eSpark-Consulting-Group/brad-fairman-led-project/Design-Files/Flex-Cable-LED Board_v2.0/Deliverables/Renderings/3D_Top_View.PNG

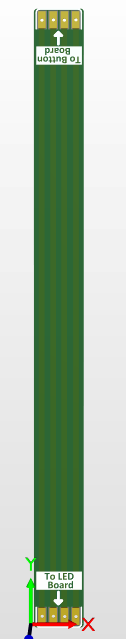
Design-Files/Flex-Cable-LED Board_v2.0/Deliverables/Renderings/3D_Top_View.PNG
