eSpark-Consulting-Group/brad-fairman-led-project/README.md

# Sekure Networks LED Project
#### Client Name: Brad Fairman
