eSpark-Consulting-Group/brad-fairman-led-project/Firmware/Arduino/LED-Project/README.md

# Sekure Networks LED Project
#### Client Name: Brad Fairman

<p>This arduino project requires MegaTINYcore Board Library to be installed first.</p>
<p>Press File>Preferences and add the following link into the "Additional Board Manager URL:" field.</p>
<p>http://drazzy.com/package_drazzy.com_index.json</p>

<p>Select ATtiny1616 as chip and 20MHz internal clock.</p>
