eSpark-Consulting-Group/brad-fairman-led-project/Design-Files/Button-Board_v2.0/Deliverables/Renderings/2D_Bottom_Layer.png

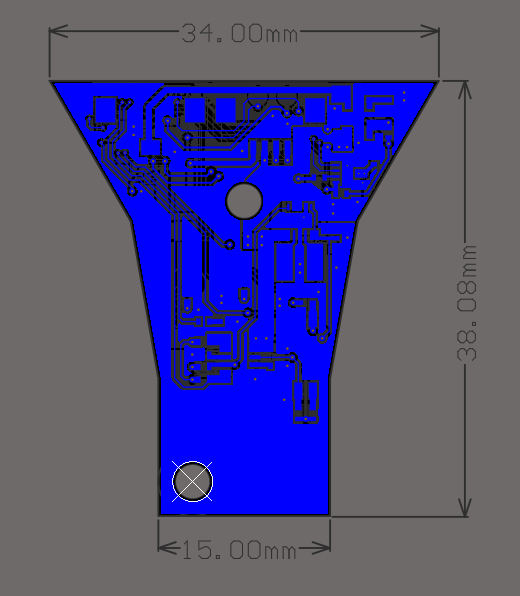
Design-Files/Button-Board_v2.0/Deliverables/Renderings/2D_Bottom_Layer.png
