eSpark-Consulting-Group/brad-fairman-led-project/Design-Files/Button-Board_v2.0/Deliverables/Renderings/3D_Isometric-View.png

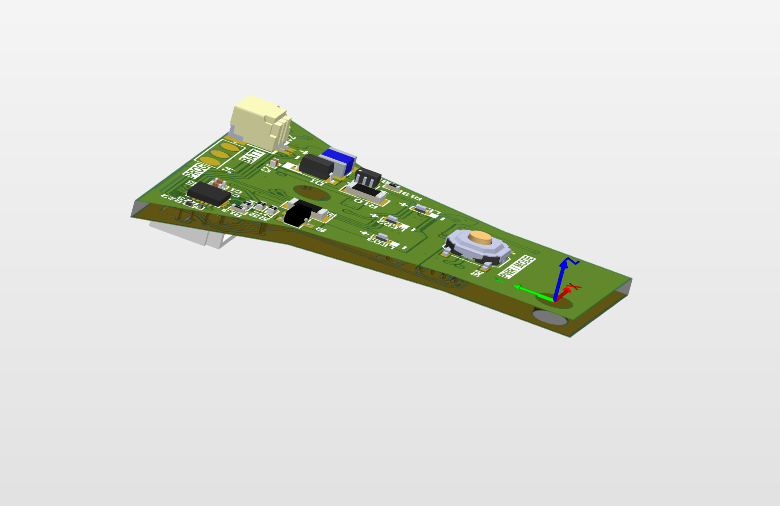
Design-Files/Button-Board_v2.0/Deliverables/Renderings/3D_Isometric-View.png
