eSpark-Consulting-Group/brad-fairman-led-project/Design-Files/Flex-Cable-LED Board_v2.0/Deliverables/Renderings/2D_C_View.PNG

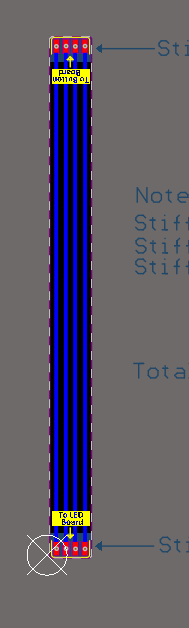
Design-Files/Flex-Cable-LED Board_v2.0/Deliverables/Renderings/2D_C_View.PNG
