eSpark-Consulting-Group/brad-fairman-led-project/Design-Files/Flex-Cable-USB_v2.0/Deliverables/Renderings/2D_Bottom_Layer.PNG

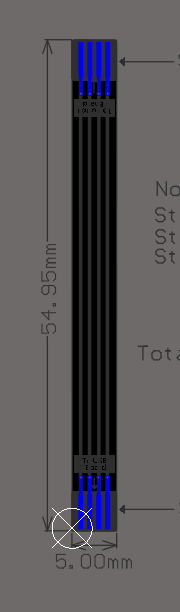
Design-Files/Flex-Cable-USB_v2.0/Deliverables/Renderings/2D_Bottom_Layer.PNG
