eSpark-Consulting-Group/brad-fairman-led-project/Design-Files/Flex-Cable-USB_v2.0/Deliverables/Renderings/2D_C_View.PNG

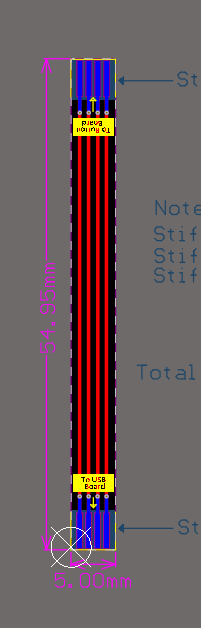
Design-Files/Flex-Cable-USB_v2.0/Deliverables/Renderings/2D_C_View.PNG
