eSpark-Consulting-Group/brad-fairman-led-project/Design-Files/Flex-Cable-USB_v2.0/Deliverables/Renderings/3D_Bottom_View.PNG

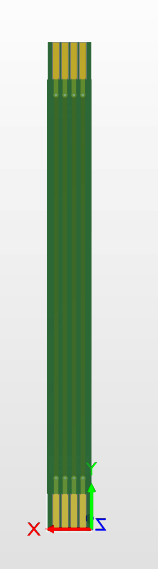
Design-Files/Flex-Cable-USB_v2.0/Deliverables/Renderings/3D_Bottom_View.PNG
