eSpark-Consulting-Group/brad-fairman-led-project/Design-Files/LED-Board_v2.0/Deliverables/Renderings/2D_Copper_Layer.png

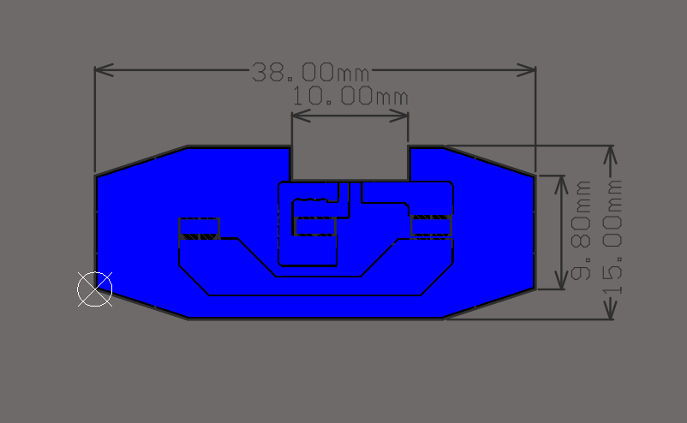
Design-Files/LED-Board_v2.0/Deliverables/Renderings/2D_Copper_Layer.png
