eSpark-Consulting-Group/brad-fairman-led-project/Design-Files/LED-Board_v2.0/Deliverables/Renderings/3D_Isometric_View.PNG

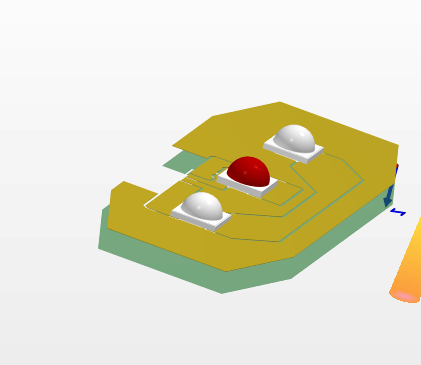
Design-Files/LED-Board_v2.0/Deliverables/Renderings/3D_Isometric_View.PNG
