eSpark-Consulting-Group/brad-fairman-led-project/Design-Files/LED-Board_v2.0/Deliverables/Renderings/3D_Top_View.PNG.png

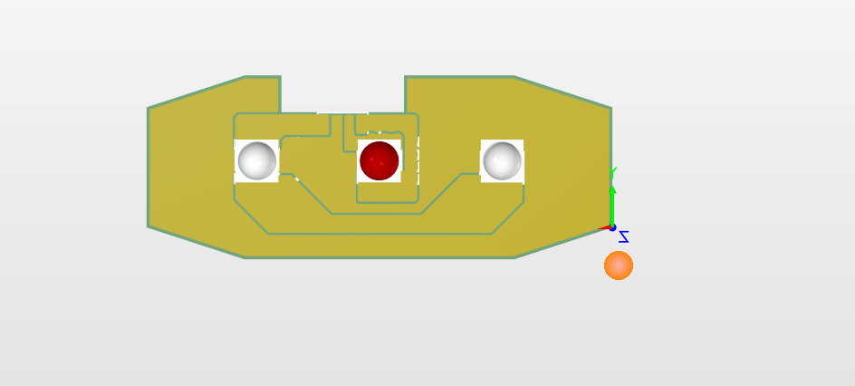
Design-Files/LED-Board_v2.0/Deliverables/Renderings/3D_Top_View.PNG.png
