eSpark-Consulting-Group/brad-fairman-led-project/Design-Files/USB-Board_v2.0/Deliverables/Renderings/2D_Top-Layer.png

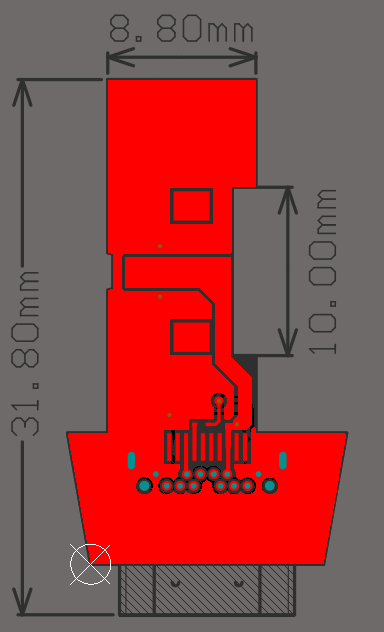
Design-Files/USB-Board_v2.0/Deliverables/Renderings/2D_Top-Layer.png
