eSpark-Consulting-Group/brad-fairman-led-project/Design-Files/Button-Board_v2.0/Deliverables/BOM/Button-Board_v2.0.xlsx

# | Item Type | Designator | Description | Footprint | Manufacturer Part Number | Manufacturer | Comment | Quantity | #Column Name Error:' Remarks
1 | Capacitor, [NoParam] | C1, C10, C12 | 1 µF ±20% 6.3V Ceramic Capacitor X5R 0201 (0603 Metric), CAP CER 1UF 16V X5R 0402, CAP CER 1UF 25V X5R 0402 | Cap-0402 | GRM033R60J105MEA2D, CC0402KRX5R7BB105, GRM155R61E105KA12D | Murata Electronics, Yageo, Murata | 1uF | 3
2 | Capacitor | C2, C15 | 0.1 µF ±10% 16V Ceramic Capacitor X7R 0402 (1005 Metric), CAP CER 0.1UF 16V X7R 0402 | Cap-0402 | GRM155R71C104KA88J, GRM155R71C104KA88D | Murata Electronics, Murata | 0.1uF | 2
3 | Capacitor | C3, C7 | CAP CER 4.7UF 16V X5R 0402 | Cap-0402 | CL05A475MO5NUNC | Samsung | 4.7uF | 2
4 | Capacitor | C4, C6, C8, C9 | CAP CER 10UF 10V X5R 0402 | Cap-0402 | CL05A106MP5NUNC | Samsung | 10uF | 4
5 | Capacitor | C13, C14 | CAP CER 0.68UF 10V X5R 0402 | Cap-0402 | CC0402KRX5R6BB684 | Yageo | 680nF | 2
6 | Diode | D1 | DIODE SCHOTTKY 40V 1A SOD123 | SOD-123 | 1N5819HW-7-F | Diodes | 1N5819HW-7-F | 1
7 | FPC-1mm | J1, J3 | 4 Position FFC, FPC Connector Contacts, Top and Bottom 0.039" (1.00mm) Surface Mount, Right Angle | XF3M(1)-0415-1B | XF3M(1)-0415-1B | Omron Electronics Inc-EMC Div | XF3M(1)-0415-1B | 2
8 | Connector | J2 | Connector Header Surface Mount, Right Angle 2 position 0.039 _1.00mm_ | SM02B-SRSS-TB(LF)(SN) | SM02B-SRSS-TB_LF__SN_ | JST Sales | SM02B-SRSS-TB(LF)(SN) | 1
9 | Male Header | J4 | CONN HEADER VERT 3POS 2.54MM | 3 Pin POGO | 68000-103HLF |  | 3 Pin POGO | 1
10 | Inductor | L1 | FIXED IND 4.7UH 1.6A 157MOHM SMD | IND-1210_ | DFE322512F-4R7M=P2 | Murata | 4.7uH | 1
11 | Inductor | L2 | 2.34A 1.5uH Shielded Power Inductors ±20% SMD Power Inductors ROHS | LVT303012-1R5M-N | LVT303012-1R5M-N | Chilisin Elec | 1.5uH | 1
12 | LED | LED1, LED2, LED3 | LED GREEN CLEAR CHIP SMD | LED-0402 | XZVG68W-2 | SunLED | XZVG68W-2 | 3
13 | Mosfet | Q1 | SOT-23 MOSFETs ROHS | SOT-23 | FDN335N | onsemi | FDN335N | 1
14 | Transistor | Q2 | TRANS NPN 40V 0.2A SOT523 | SOT-523 | MMBT3904T-7-F | Diodes Zetex | MMBT3904T-7-F | 1
15 | Resistor | R1, R3, R5, R7, R9, R12, R13, R17, R19, R20 | 10 kOhms ±1% 0.063W, 1/16W Chip Resistor 0402 (1005 Metric) Moisture Resistant Thick Film, RES 10K OHM 1% 1/16W 0402, RES SMD 10K OHM 0.1% 1/16W 0402 | Res-0402 | RC0402FR-0710KL, RT0402BRD0710KL | YAGEO | 10K | 10
16 | Resistor | R4 | 4.7 kOhms ±1% 0.063W, 1/16W Chip Resistor 0402 (1005 Metric) Moisture Resistant Thick Film | Res-0402 | RC0402FR-074K7L | YAGEO | 4.7K | 1
17 | Resistor | R6 | RES 470 OHM 1% 1/16W 0402 | Res-0402 | RC0402FR-07470RL | Yageo | 470R | 1
18 | Resistor | R8, R14, R15 | 100 Ohms ±1% 0.063W, 1/16W Chip Resistor 0402 (1005 Metric) Moisture Resistant Thick Film | Res-0402 | RC0402FR-07100RL | YAGEO | 100R | 3
19 | Resistors | R10 | RES 0.2 OHM 1% 1W 1206 | Res-1206 | PE1206FRF470R2L | Yageo | 200mR | 1
20 | Resistor | R11, R21 | 1 kOhms ±1% 0.063W, 1/16W Chip Resistor 0402 (1005 Metric) Moisture Resistant Thick Film, RES 1K OHM 1% 1/16W 0402 | Res-0402 | RC0402FR-071KL | YAGEO | 1K | 2
21 | Resistor | R16 | RES 5.6 OHM 1% 1/4W 1206 | Res-1206 | RC1206FR-075R6L | Yageo | 5.6Ω | 1
22 | Resistor | R18 | RES SMD 10K OHM 0.1% 1/16W 0402 | Res-0402 | RT0402BRD0710KL | Yageo | NC | 1
23 | Resistor | R22, R23 | RES 4.7K OHM 1% 1/20W 0201 | Res-0201 | RC0201FR-074K7L | Yageo | 4.7K | 2
24 | Switch | SW1 | No Gull Wing 50mA 100MΩ 80000 260gf@±50gf 12V -25℃~+85℃ 1.7mm Golden Round Button Brick nogging SPST SMD Tactile Switches ROHS | TC-0522C-1.7-260G_ | TC-0522C-1.7-260G | HCTL | TC-0522C-1.7-260G | 1
25 | IC | U1 | 4.5V~5.5V 锂离子/Polymer 1 600mA SOT-23-5 Battery Management ICs ROHS | SOT-23-5 | TP4054 | TPOWER | TP4054 | 1
26 | IC | U2 | IC PB ON/OFF CONTROLLER TSOT23-8 | TSOT-23-8 | LTC2950CTS8-1#TRPBF | Analog Devices / Linear Technology | LTC2950CTS8-1#TRPBF | 1
27 | IC | U3 | AVR tinyAVR™ 1, Functional Safety (FuSa) Microcontroller IC 8-Bit 20MHz 16KB (16K x 8) FLASH 20-VQFN (3x3) | 20-VQFN (3x3) | ATTINY1616-MNR | Microchip Tech | ATTINY1616-MNR | 1
28 | IC | U4 | IC LED DRV RGLTR PWM 1.2A SC70-5 | SC70-5 | TPS92360DCKR | Texas Instruments | TPS92360DCKR | 1
29 | IC | U5 | IC BATT MON LI-ION 1CELL 8TDFN | 8-TDFN-EP (2x2) | MAX17048G+T10 | Maxim | MAX17048G+T10 | 1
30 | IC | U6 | IC REG BUCK BST 3.3V 0.9A 10SON | SON-10-EP(2.5x2.5) | TPS63031DSKR | Texas Instruments | TPS63031DSKR | 1
31 | Optocouplers | U7 | OPTOISOLATOR 3.75KV TRANS 4-SOP | SOP-4-1.27mm pitch Body 2.6mm | TCMT1107 | Vishay Semiconductors | TCMT1107 | 1
