eSpark-Consulting-Group/brad-fairman-led-project/Design-Files/LED-Board_v2.0/Deliverables/BOM/LED-Board_v1.0.xlsx

# | Item Type | Designator | Description | Footprint | Manufacturer Part Number | Manufacturer | Value | Quantity | Remarks
1 | Connector | J1 | 4 Position FFC, FPC Connector Contacts, Top and Bottom 0.039" (1.00mm) Surface Mount, Right Angle | Custom | XF3M(1)-0415-1B | Omron Electronics Inc-EMC Div | - | 1
2 | LED | LED1, LED3 | LED Lighting LH351B White, Cool 5700K 2.8V 350mA 120° 1414 (3535 Metric) | 1414 (3535 Metric) | SPHWH2L3D30CD4QTP3 | Samsung Semiconductor, Inc. | White | 2
3 | LED | LED2 | LED Lighting Color LH351H Red 660nm (650nm ~ 670nm) | Custom | SPHRD2L3DH20E7W41J | Samsung Semiconductor, Inc. | RED | 1
