eSpark-Consulting-Group/brad-fairman-led-project/Design-Files/USB-Board_v2.0/Deliverables/BOM/USB_Board_v2.0.xlsx

# | Item Type | Designator | Description | Footprint | Manufacturer Part Number | Manufacturer | Value | Quantity | Remarks
1 | Diode | D1 | 5V Clamp 7A (8/20µs) Ipp Tvs Diode Surface Mount DSN0603-2 | Custom | PESD5V0H1BSFYL | Nexperia USA Inc. | - | 1
2 | Connector | J1 | Type C, USB 3.2 Gen 2x2, 20 Gbps, 20 Vac, 5 A, Right Angle, Gold Flash, Surface Mount, Black Insulator, USB Receptacle | Custom | UJ32-C-H-G-H2-SMT-TR | CUI Devices | - | 1
3 | Connector | J2 | 4 Position FFC, FPC Connector Contacts, Top and Bottom 0.039" (1.00mm) Surface Mount, Right Angle | Custom | XF3M(1)-0415-1B | Omron Electronics Inc-EMC Div | - | 1
4 | Resistor | R1, R2 | RES 5.1K OHM 1% 1/20W 0201 | Res-0201 | RC0201FR-075K1L | Yageo | 5.1K | 2
