eSpark-Consulting-Group/brad-fairman-led-project/Design-Files/Button-Board_v2.0/Deliverables/Supporting Files/PCB_Button_Board_v2.0.step

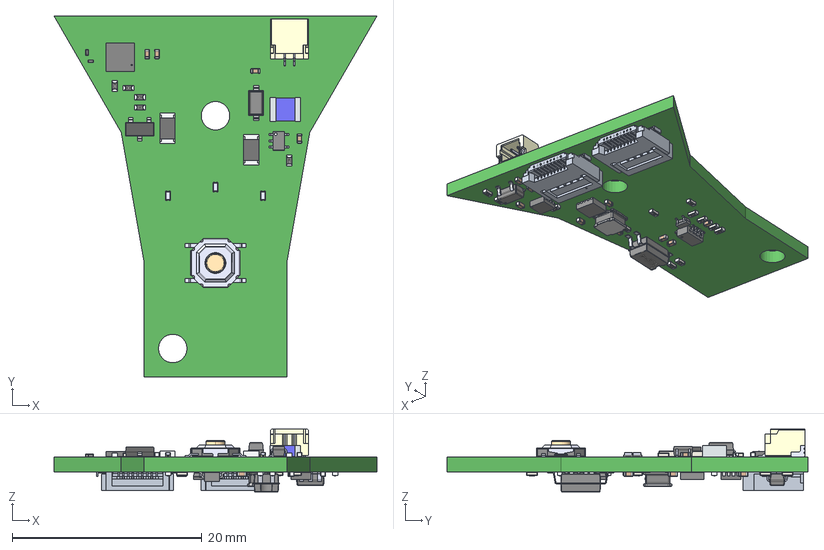
[picture p22: CAD file, 2024-07-25]
Design-Files/Button-Board_v2.0/Deliverables/Supporting Files/PCB_Button_Board_v2.0.step
34.0 x 38.0 x 6.60 mm
User_Library-CR3216-1206 x 2
1N5819HW-7-F--3DModel-STEP-56544
User_Library-Capacitor_0402 x 13
SN74LVC1G08DCKR
User_Library-0201(0603M)_Res x 2
User_Library-LED-0402 x 3
User_Library-SOP-4-1
TPS63030DSKR
21-0168E_T822-1_MXM
User_Library-RES_1005-0402 x 18
User_Library-SOT-523
PTS526_SMG15_SMTR2_LFS--3DModel-STEP-1
term1
term2
VQFN20_3X3_MCH
Part_TSOT-23-8_____________
Fuss_TSOT-23-8_____________ x 12
SN74LV1T34DBVR
CircuitWorks-SOT-23
xf3m_1_-0415-1b-r100 x 2
SM02B-SRSS-TB-LF--SN---3DModel-STEP-56544
