eSpark-Consulting-Group/brad-fairman-led-project/Design-Files/Flex-Cable-LED Board_v2.0/Deliverables/Supporting Files/PCB_Flex_LED_v2.0.step

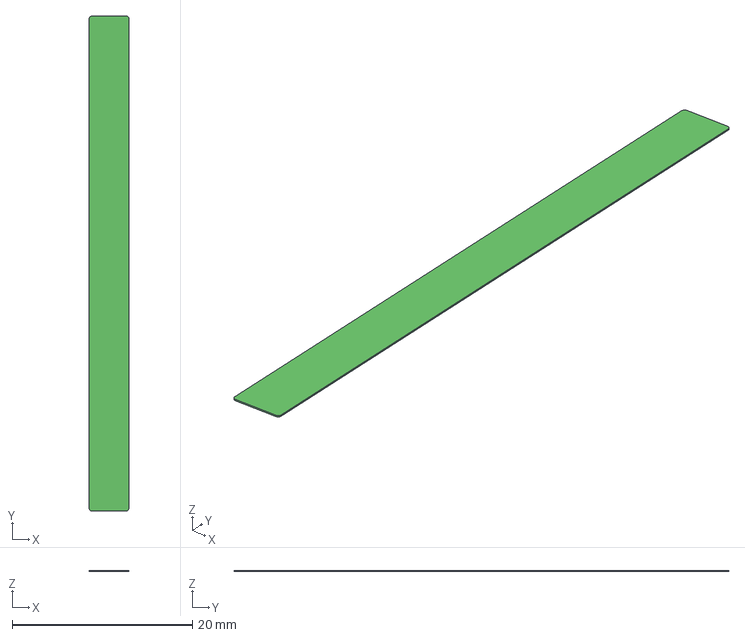
[picture p23: CAD file, 2024-07-23]
Design-Files/Flex-Cable-LED Board_v2.0/Deliverables/Supporting Files/PCB_Flex_LED_v2.0.step
4.43 x 55.0 x 0.121 mm
