eSpark-Consulting-Group/brad-fairman-led-project/Design-Files/Flex-Cable-USB_v2.0/Deliverables/Supporting Files/PCB_Flex_USB_v2.0.step

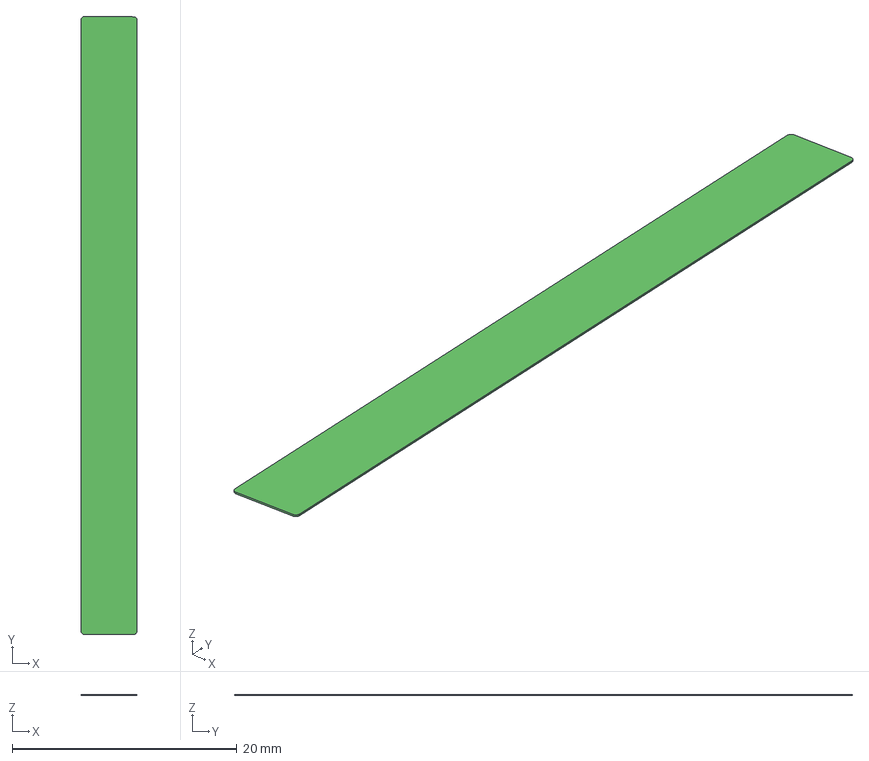
[picture p24: CAD file, 2024-07-23]
Design-Files/Flex-Cable-USB_v2.0/Deliverables/Supporting Files/PCB_Flex_USB_v2.0.step
4.99 x 55.0 x 0.121 mm
