eSpark-Consulting-Group/brad-fairman-led-project/Design-Files/LED-Board_v2.0/Deliverables/Supporting Files/PCB_LED_Board_v2.0.step

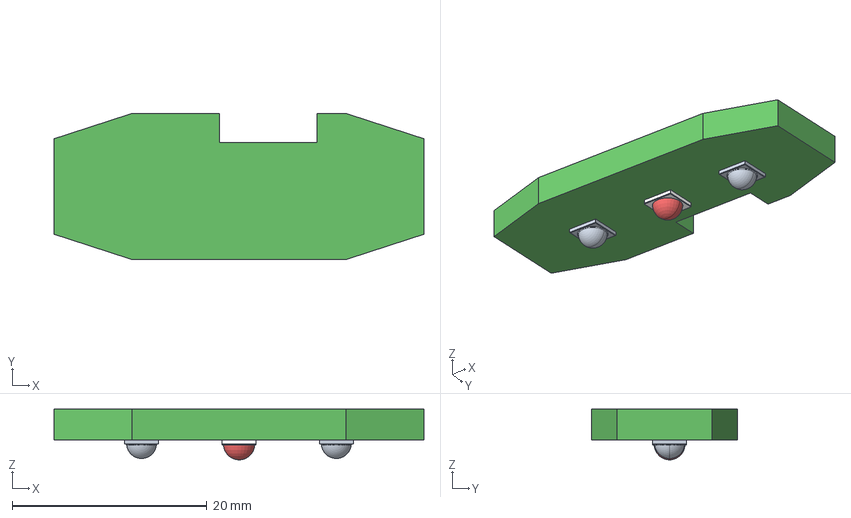
[picture p25: CAD file, 2024-07-23]
Design-Files/LED-Board_v2.0/Deliverables/Supporting Files/PCB_LED_Board_v2.0.step
38.0 x 15.0 x 5.21 mm
LH351B x 2
LH351B-v3
