eSpark-Consulting-Group/brad-fairman-led-project/Design-Files/Flex-Cable-USB/Deliverables/Supporting Files/PCB_Flex_USB_v1.0.DXF

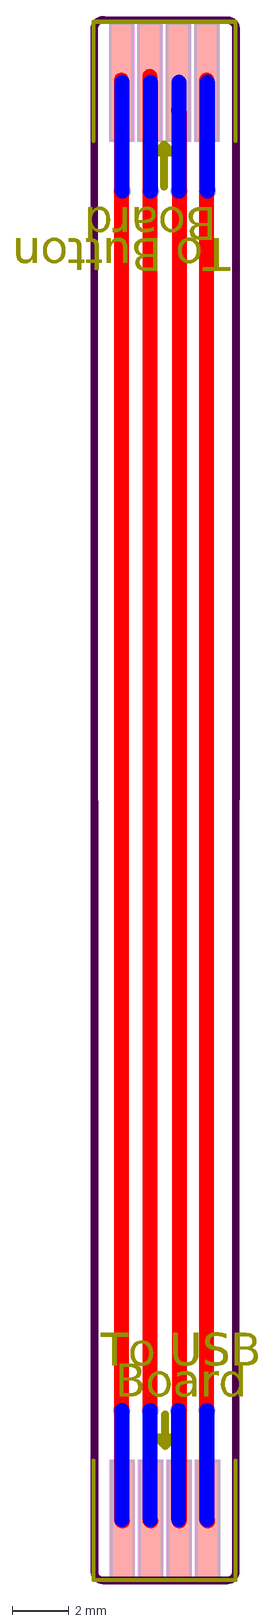
[picture p26: CAD file, 2024-07-18, an earlier design]
Design-Files/Flex-Cable-USB/Deliverables/Supporting Files/PCB_Flex_USB_v1.0.DXF
Board
To USB
To Button
