eSpark-Consulting-Group/brad-fairman-led-project/Design-Files/USB-Board_v1.0/Deliverables/Supporting Files/PCB_USB_Board_v1.0.step

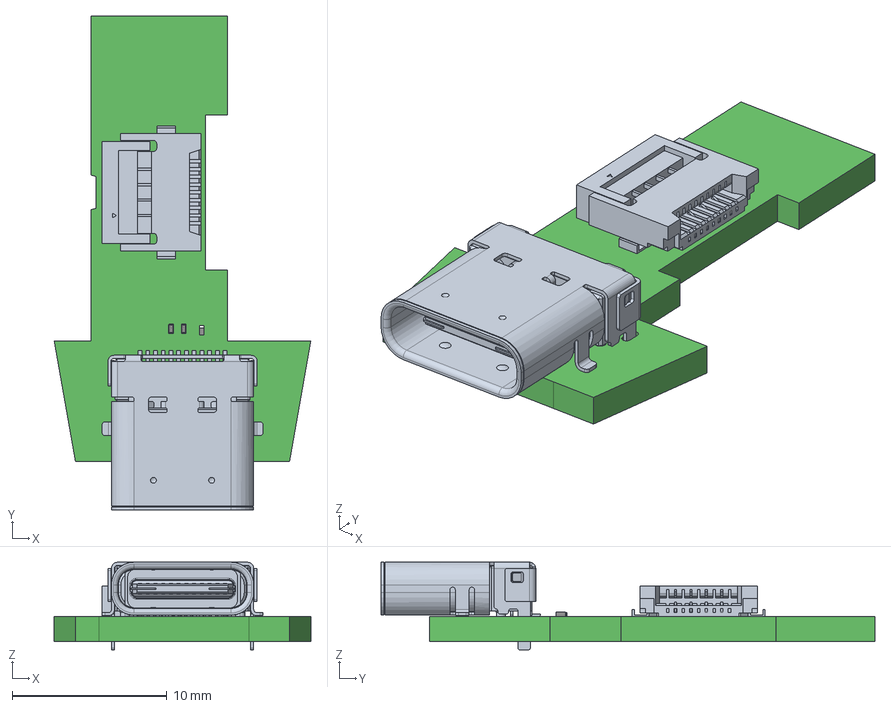
[picture p27: CAD file, 2024-07-18, an earlier design]
Design-Files/USB-Board_v1.0/Deliverables/Supporting Files/PCB_USB_Board_v1.0.step
16.6 x 31.9 x 5.66 mm
User_Library-0201(0603M)_Res x 2
xf3m_1_-0415-1b-r100
PESD5V0H1BSF
CUI_DEVICES_UJ32-C-H-G-H2-SMT-TR
