eSpark-Consulting-Group/brad-fairman-led-project/(list of files, cad)

Other CAD files:
Design-Files/USB-Board_v2.0/Deliverables/Supporting Files/PCB_USB_Board_v2.0.DWG
Design-Files/Button-Board_v1.0/Deliverables/Supporting Files/PCB_Button_Board_v1.0.step
Design-Files/Flex-Cable-LED Board/Deliverables/Supporting Files/PCB_Flex_LED_v1.0.step
Design-Files/LED-Board_v1.0/Deliverables/Supporting Files/PCB_LED_Board_v1.0.step
Design-Files/Button-Board_v1.0/Deliverables/Supporting Files/PCB_Button_Board_v1.0.DWG
Design-Files/Button-Board_v1.0/Deliverables/Supporting Files/PCB_Button_Board_v1.0.DXF
Design-Files/Button-Board_v2.0/Deliverables/Supporting Files/PCB_Button_Board_v2.0.DWG
Design-Files/Button-Board_v2.0/Deliverables/Supporting Files/PCB_Button_Board_v2.0.DXF
Design-Files/Flex-Cable-LED Board/Deliverables/Supporting Files/PCB_Flex_LED_v1.0.DWG
Design-Files/Flex-Cable-LED Board/Deliverables/Supporting Files/PCB_Flex_LED_v1.0.DXF
Design-Files/Flex-Cable-LED Board_v2.0/Deliverables/Supporting Files/PCB_Flex_LED_v2.0.DWG
Design-Files/Flex-Cable-LED Board_v2.0/Deliverables/Supporting Files/PCB_Flex_LED_v2.0.DXF
Design-Files/Flex-Cable-USB_v2.0/Deliverables/Supporting Files/PCB_Flex_USB_v2.0.DWG
Design-Files/LED-Board_v1.0/Deliverables/Supporting Files/PCB_LED_Board_v1.0.DWG
Design-Files/LED-Board_v1.0/Deliverables/Supporting Files/PCB_LED_Board_v1.0.DXF
Design-Files/LED-Board_v2.0/Deliverables/Supporting Files/PCB_LED_Board_v2.0.DWG
Design-Files/LED-Board_v2.0/Deliverables/Supporting Files/PCB_LED_Board_v2.0.DXF
Design-Files/USB-Board_v1.0/Deliverables/Supporting Files/PCB_USB_Board_v1.0.DXF
