eSpark-Consulting-Group/brad-fairman-led-project/Firmware/LED-Project.X/queuelogs/debugtool.txt

232 1724359588259 GEN4_CONNECT_DIAGNOSTICS:Calling Update on plug and play observer com.microchip.mplab.mdbcore.RI4Tool.RI4ToolBase$RI4PlugNPlayObserver@693e18aa
232 1724359588259 GEN4_CONNECT_DIAGNOSTICS:Entering plug and play Update(). Attached PID = 9012
232 1724359588259 GEN4_CONNECT_DIAGNOSTICS:Entering MPLABCommEvent handler
232 1724359588260 GEN4_CONNECT_DIAGNOSTICS:MPLABCommEvent.pid = 9012
232 1724359588260 GEN4_CONNECT_DIAGNOSTICS:eventType = MPLABCOMM_TOOL_UNPLUGGED
232 1724359588261 GEN4_CONNECT_DIAGNOSTICS:Exiting plug and play Update()
67292 1724359589115 GEN4_CONNECT_DIAGNOSTICS:MPLABCommTool is null

67292 1724359589115 GEN4_TO_CONTROLLER_LOG:GEN4_DEBUG_INT_LOG_ATtiny1616 Pre:EndDebugSession
67292 1724359589115 GEN4_TO_CONTROLLER_LOG:GEN4_DEBUG_INT_LOG_ATtiny1616 Payload
67292 1724359589115 GEN4_TO_CONTROLLER_LOG:GEN4_DEBUG_INT_LOG_ATtiny1616 null
67292 1724359589115 GEN4_TO_CONTROLLER_LOG:GEN4_DEBUG_INT_LOG_ATtiny1616 Payload End
67292 1724359589115 XXXX 1724359589115, Thread 67292: XXXX 1724359589115, Entering Thread 67292: Commands::runScriptBasic, script name = ExitDebugMode, timeOut = -1 ms  
67292 1724359589116 XXXX 1724359589116, Thread 67292: com.Send returned false 
67292 1724359589116 XXXX 1724359589116, Thread 67292: transfer: exception after writeHeaderAndGetResult null 
67292 1724359589116 XXXX 1724359589116, Thread 67292: XXXX 1724359589116, Entering Thread 67292: ToolCommUsb::recoverFromProtocolError, type = NO_SCRIPT  
67292 1724359589116 XXXX 1724359589116, Thread 67292: Send Abort Script Engine Command 
67292 1724359589116 XXXX 1724359589116, Thread 67292: XXXX 1724359589116, Entering Thread 67292: ToolCommUsb::killScriptEngine  
67292 1724359589116 XXXX 1724359589116, Thread 67292: com.Send returned false 
67292 1724359589116 XXXX 1724359589116, Thread 67292: Failed sending Abort Script Engine Command. Set nuclear option = true 
67292 1724359589116 XXXX 1724359589116, Thread 67292: About to nuke 
67292 1724359589116 XXXX 1724359589116, Thread 67292: XXXX 1724359589116, Entering Thread 67292: ToolCommUsb::nuclearOption  
67292 1724359589116 XXXX 1724359589116, Thread 67292: com.Send returned false
