eSpark-Consulting-Group/brad-fairman-led-project/Design-Files/Button-Board_v2.0/Deliverables/Schematics/Button-Board_v2.0.pdf

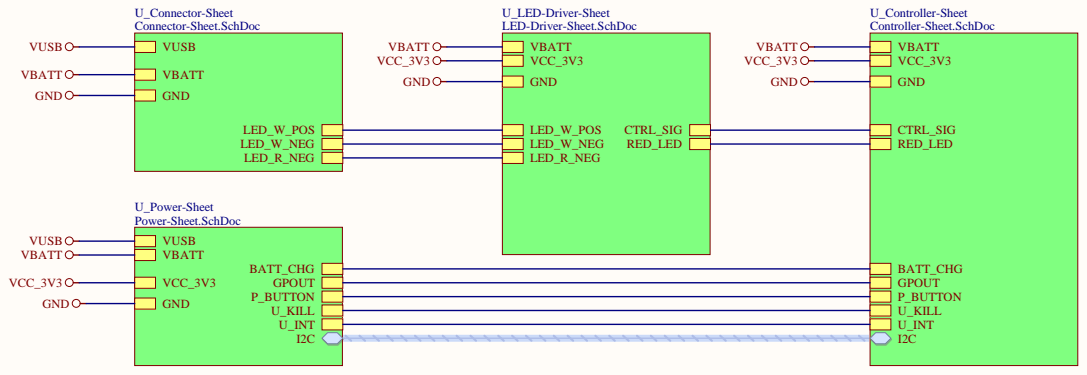
[picture p28: page 1]

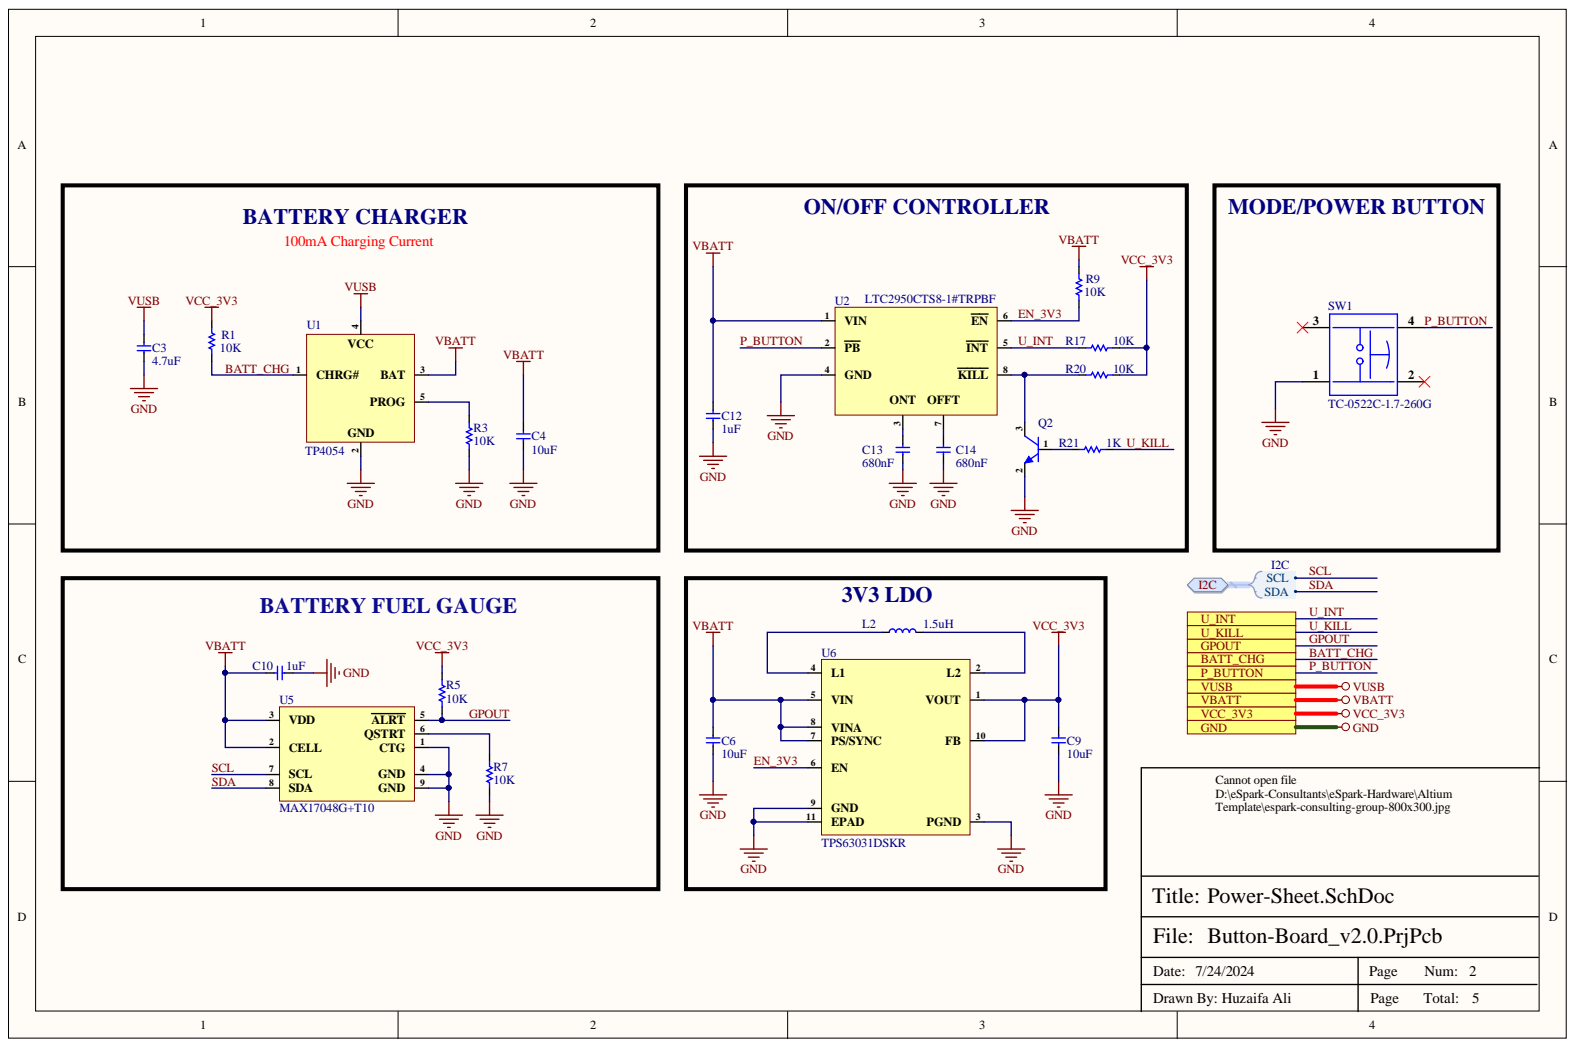
[picture p29: page 2]

Cannot open file
D:\eSpark-Consultants\eSpark-Hardware\Altium
Template\espark-consulting-group-800x300.jpg

Date: 7/24/2024 | Page Num: 2

Drawn By: Huzaifa Ali | Page Total: 5

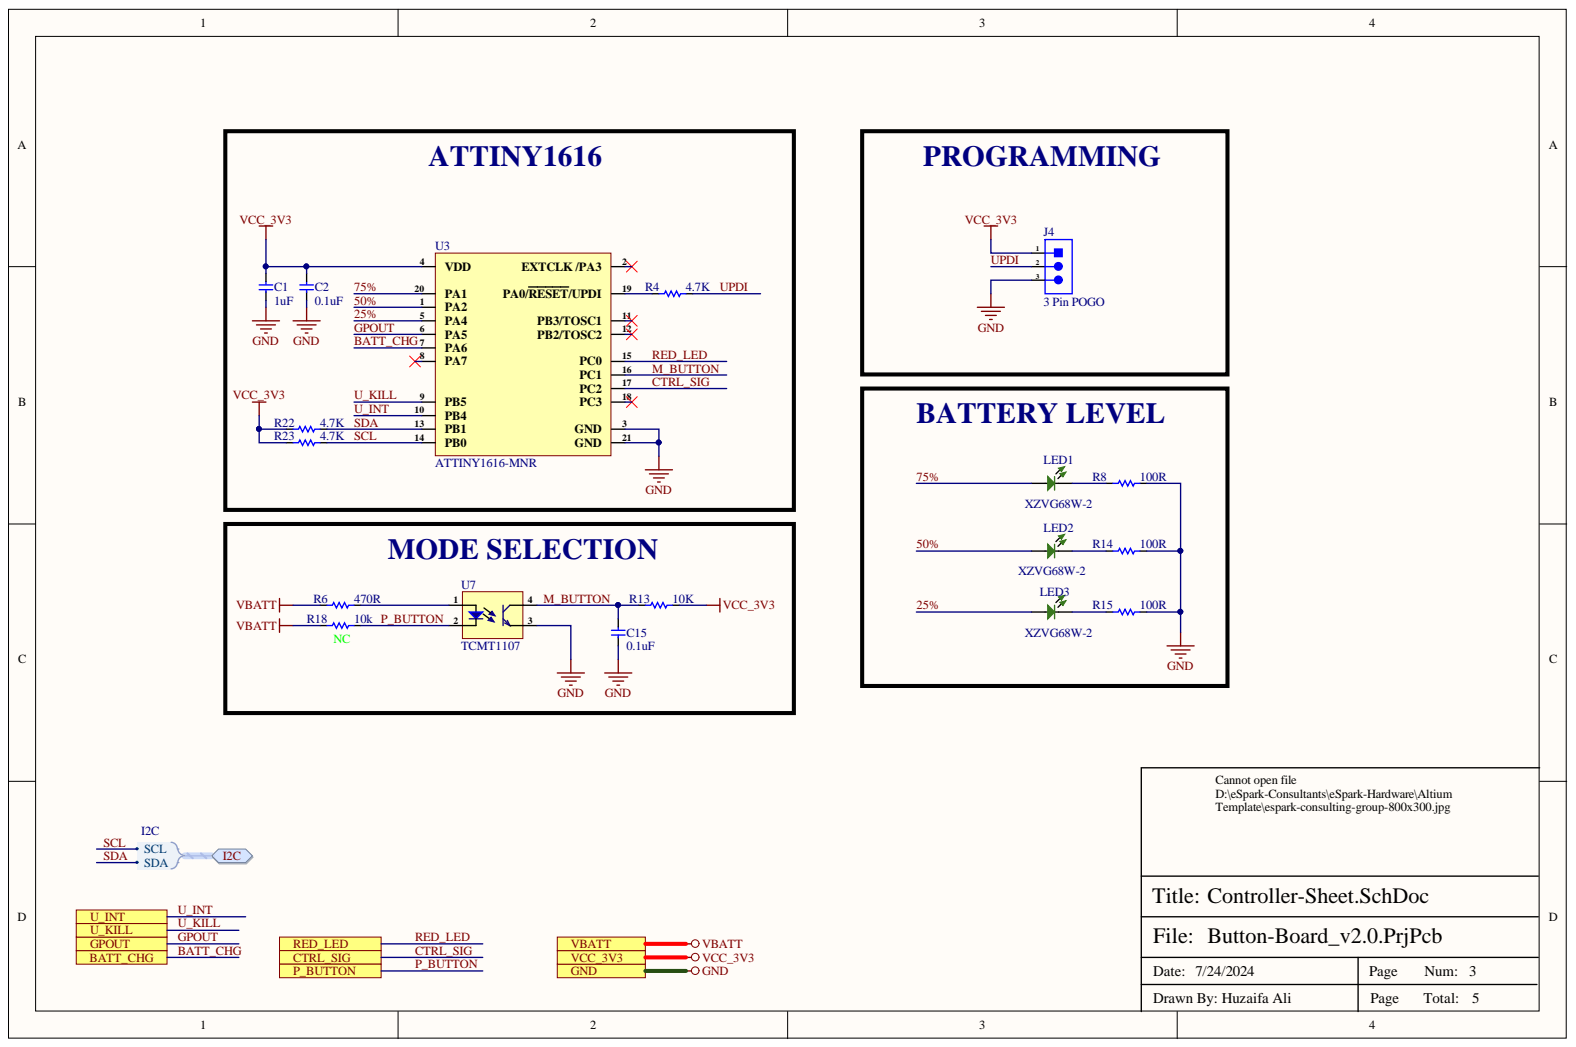
[picture p30: page 3]

Cannot open file
D:\eSpark-Consultants\eSpark-Hardware\Altium
Template\espark-consulting-group-800x300.jpg

Date: 7/24/2024 | Page Num: 3

Drawn By: Huzaifa Ali | Page Total: 5

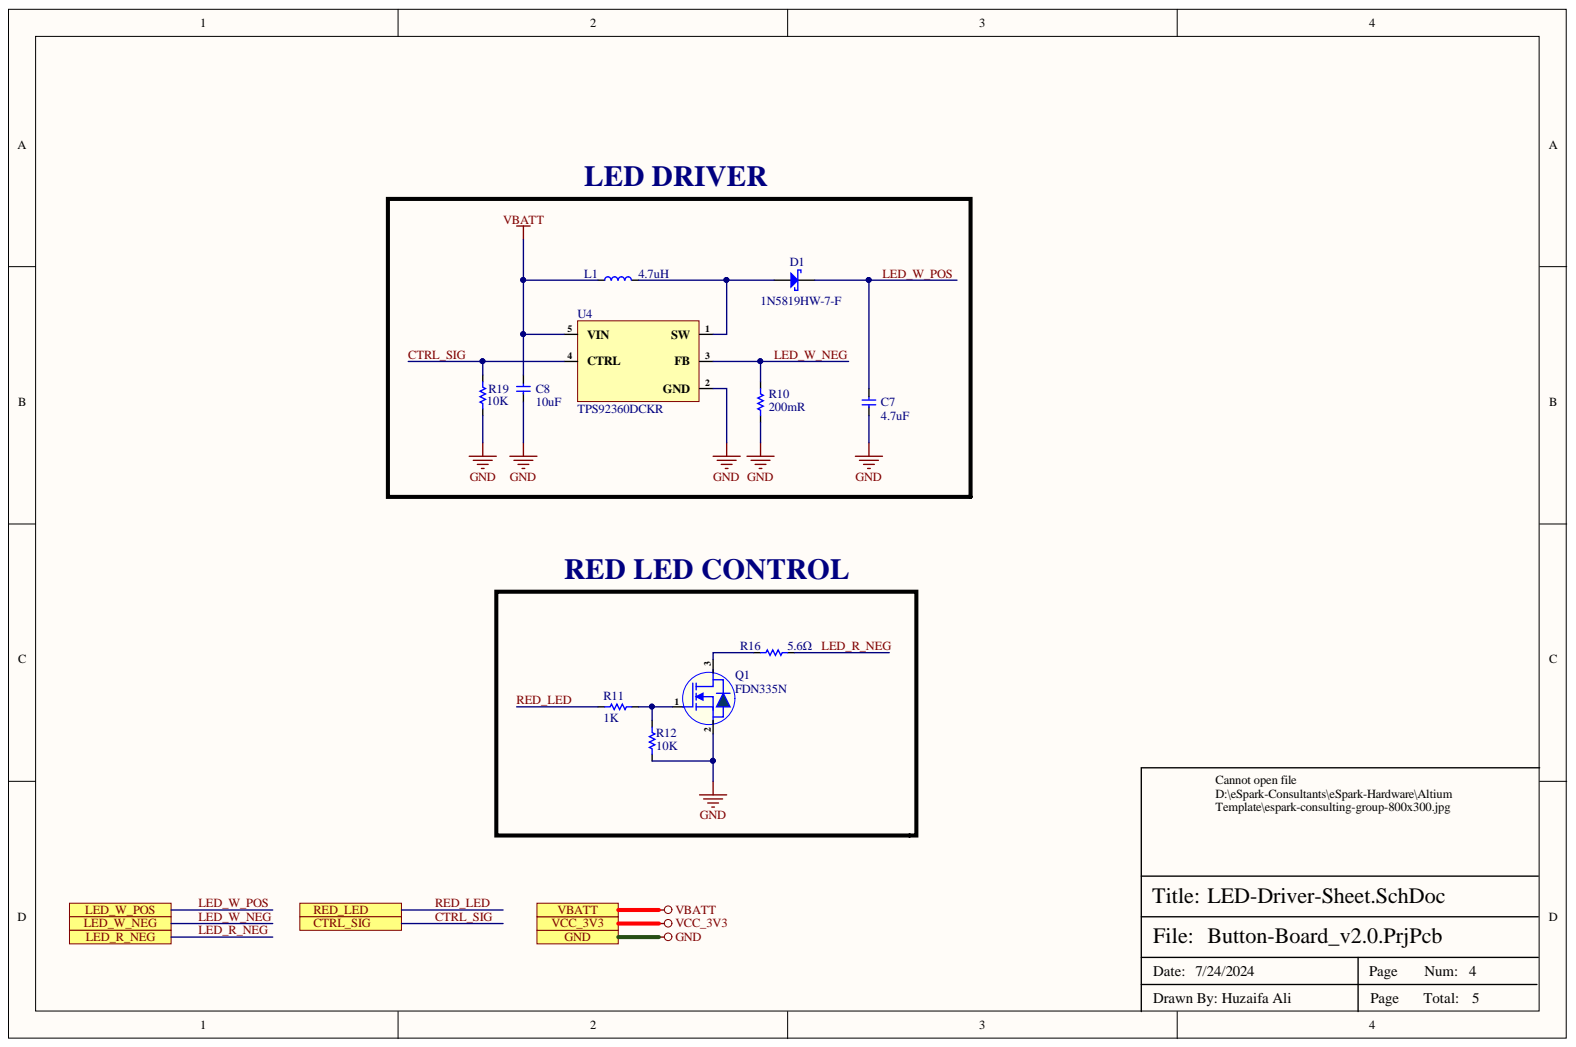
[picture p31: page 4]

Cannot open file
D:\eSpark-Consultants\eSpark-Hardware\Altium
Template\espark-consulting-group-800x300.jpg

LED-Driver-Sheet.SchDoc

Date: 7/24/2024 | Page Num: 4

Drawn By: Huzaifa Ali | Page Total: 5

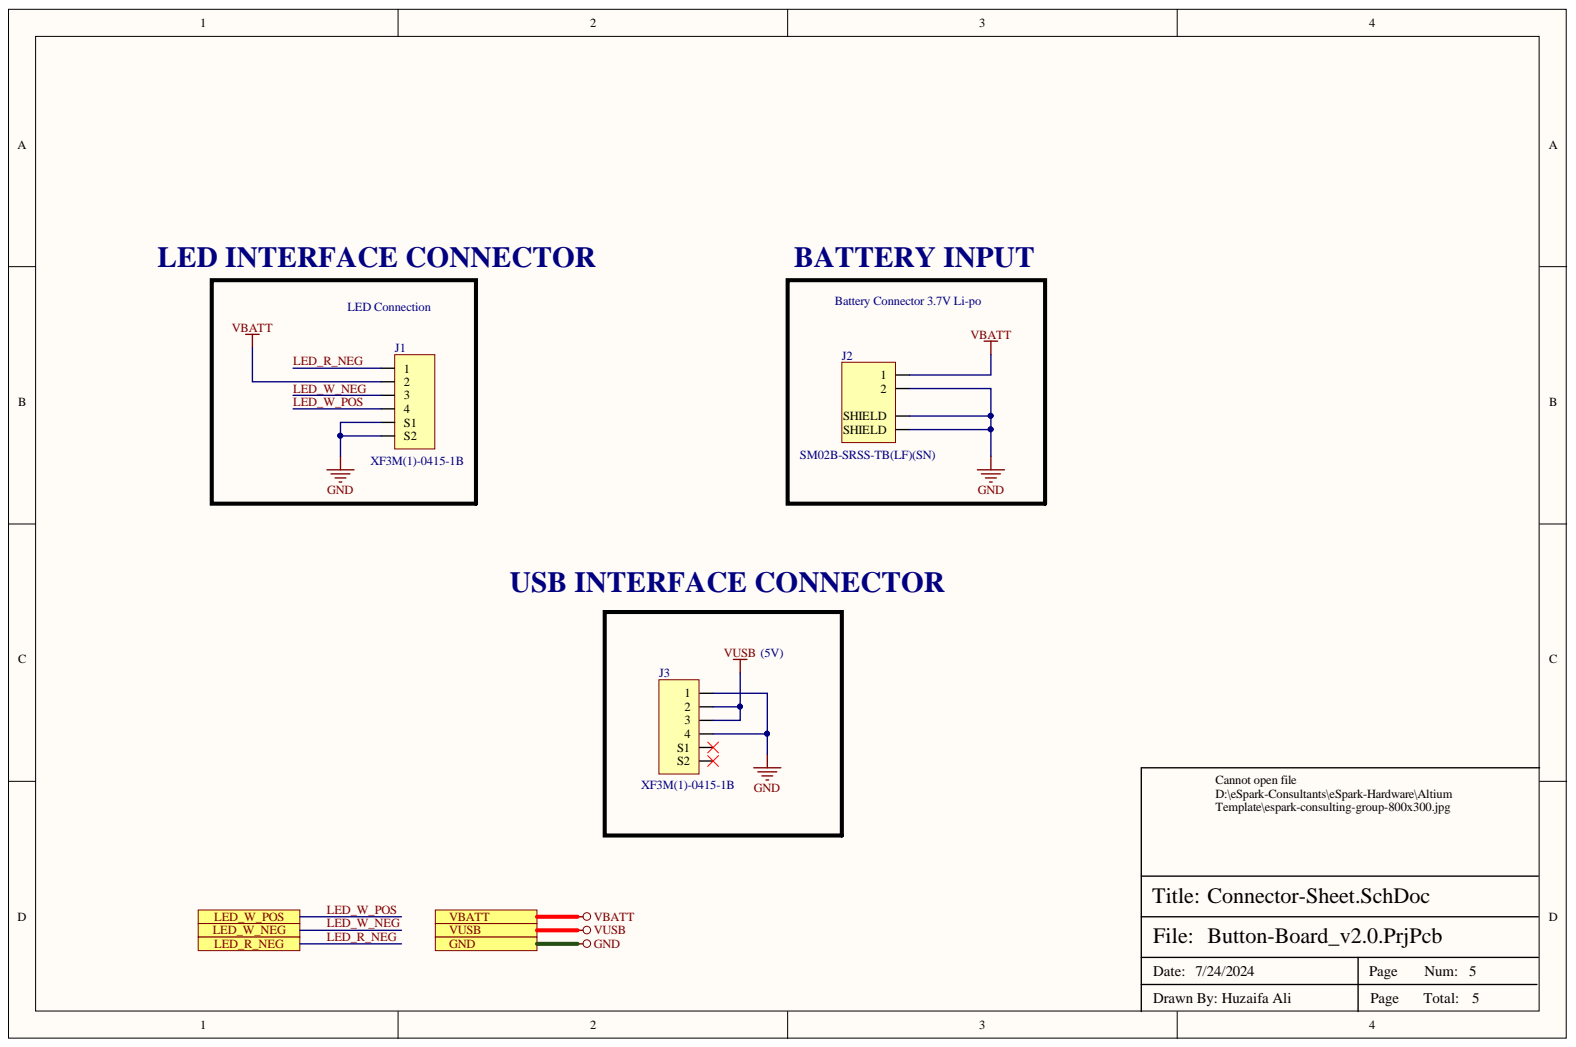
[picture p32: page 5]

Battery Connector 3.7V Li-po

SM02B-SRSS-TB(LF)(SN)

Cannot open file
D:\eSpark-Consultants\eSpark-Hardware\Altium
Template\espark-consulting-group-800x300.jpg

Date: 7/24/2024 | Page Num: 5

Drawn By: Huzaifa Ali | Page Total: 5

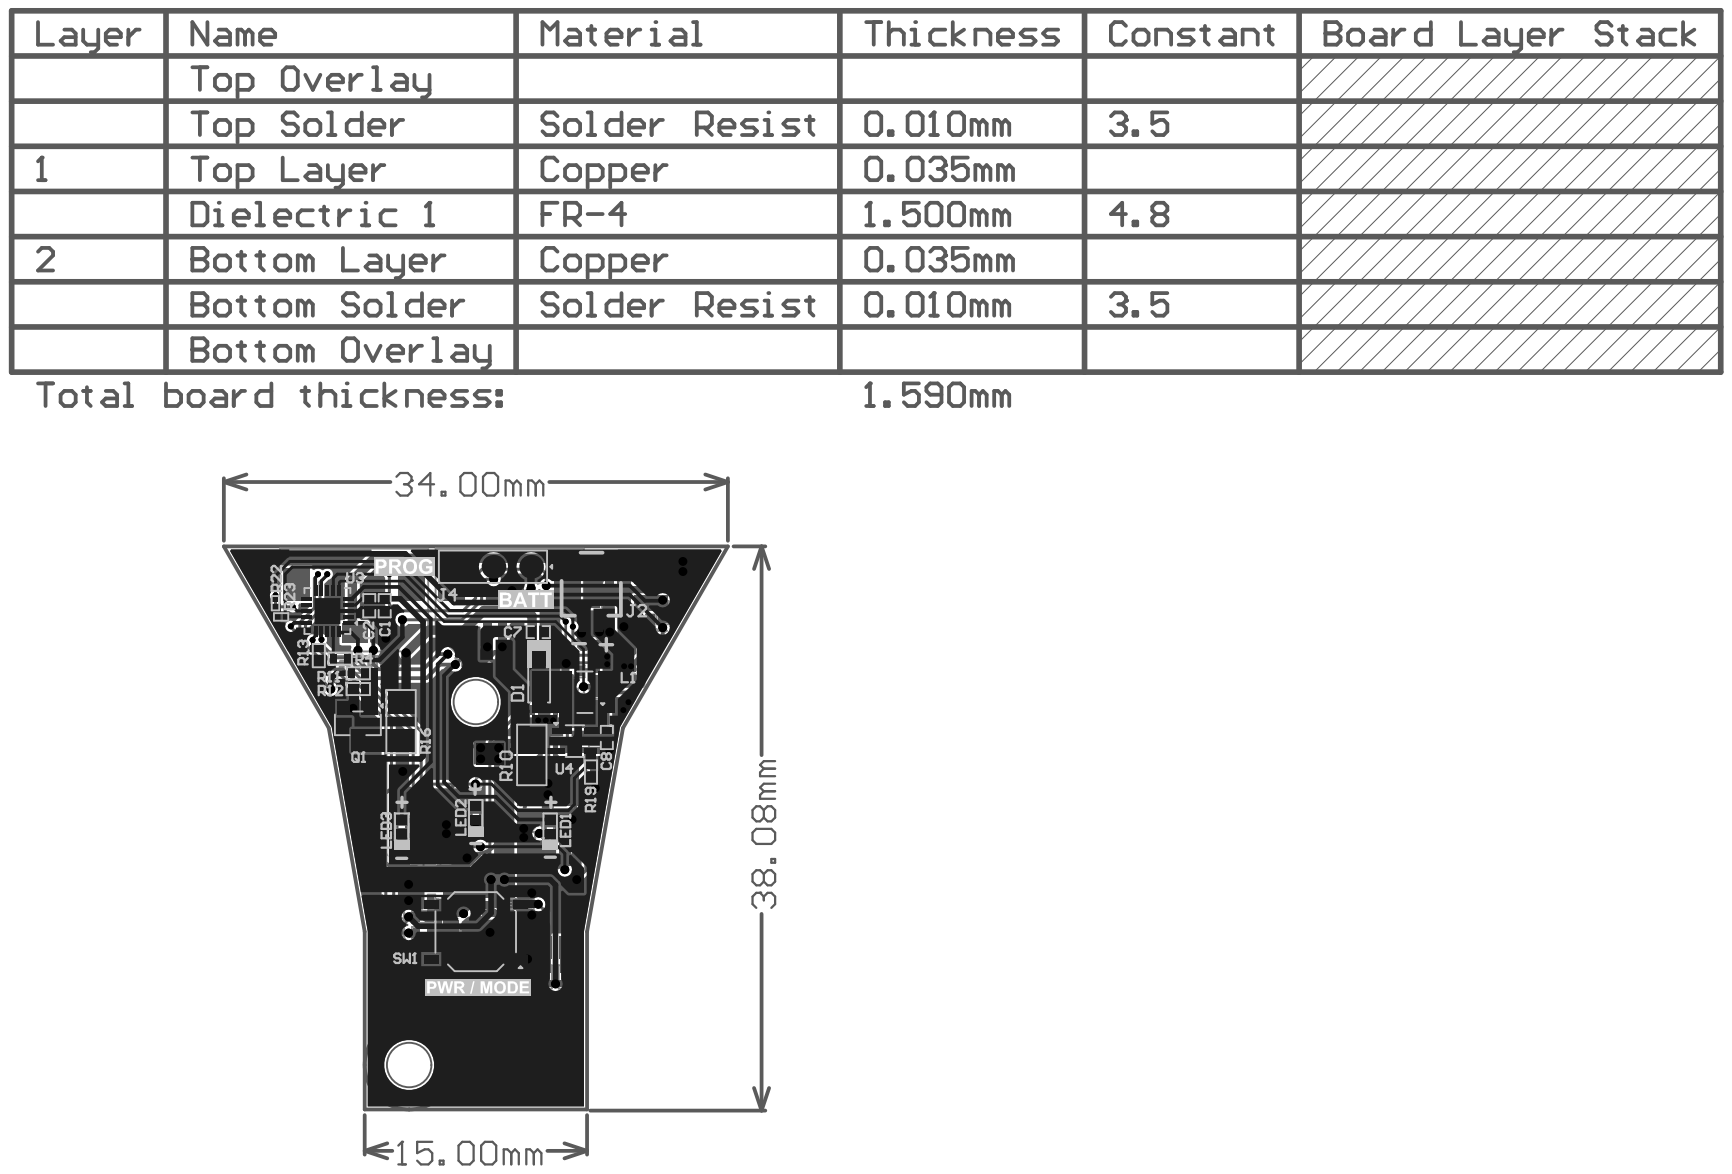
[picture p33: page 6]
