eSpark-Consulting-Group/brad-fairman-led-project/Design-Files/LED-Board_v2.0/Deliverables/Schematics/LED-Board_v2.0.pdf

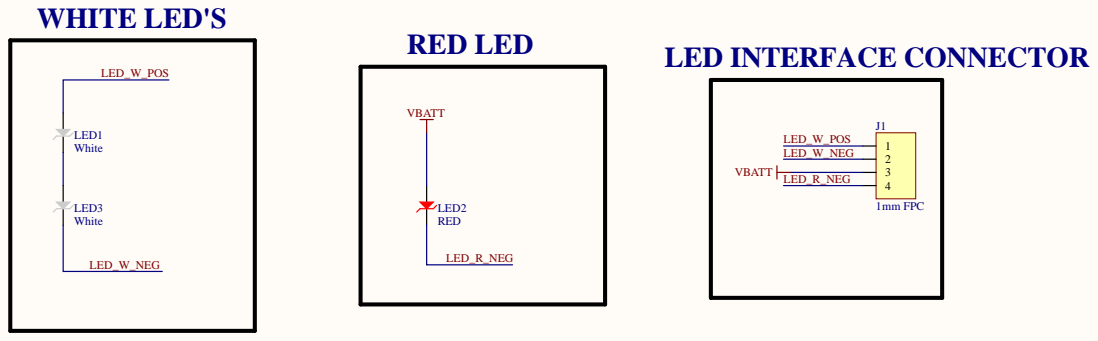
[picture p34: page 1]

Size A | Nu m b er | Revisio n

Date: 7/2 3/2 0 2 4 | Sheet o f
File: C:\Users\..\LEDs_Sheet.SchDo c | Drawn B y :

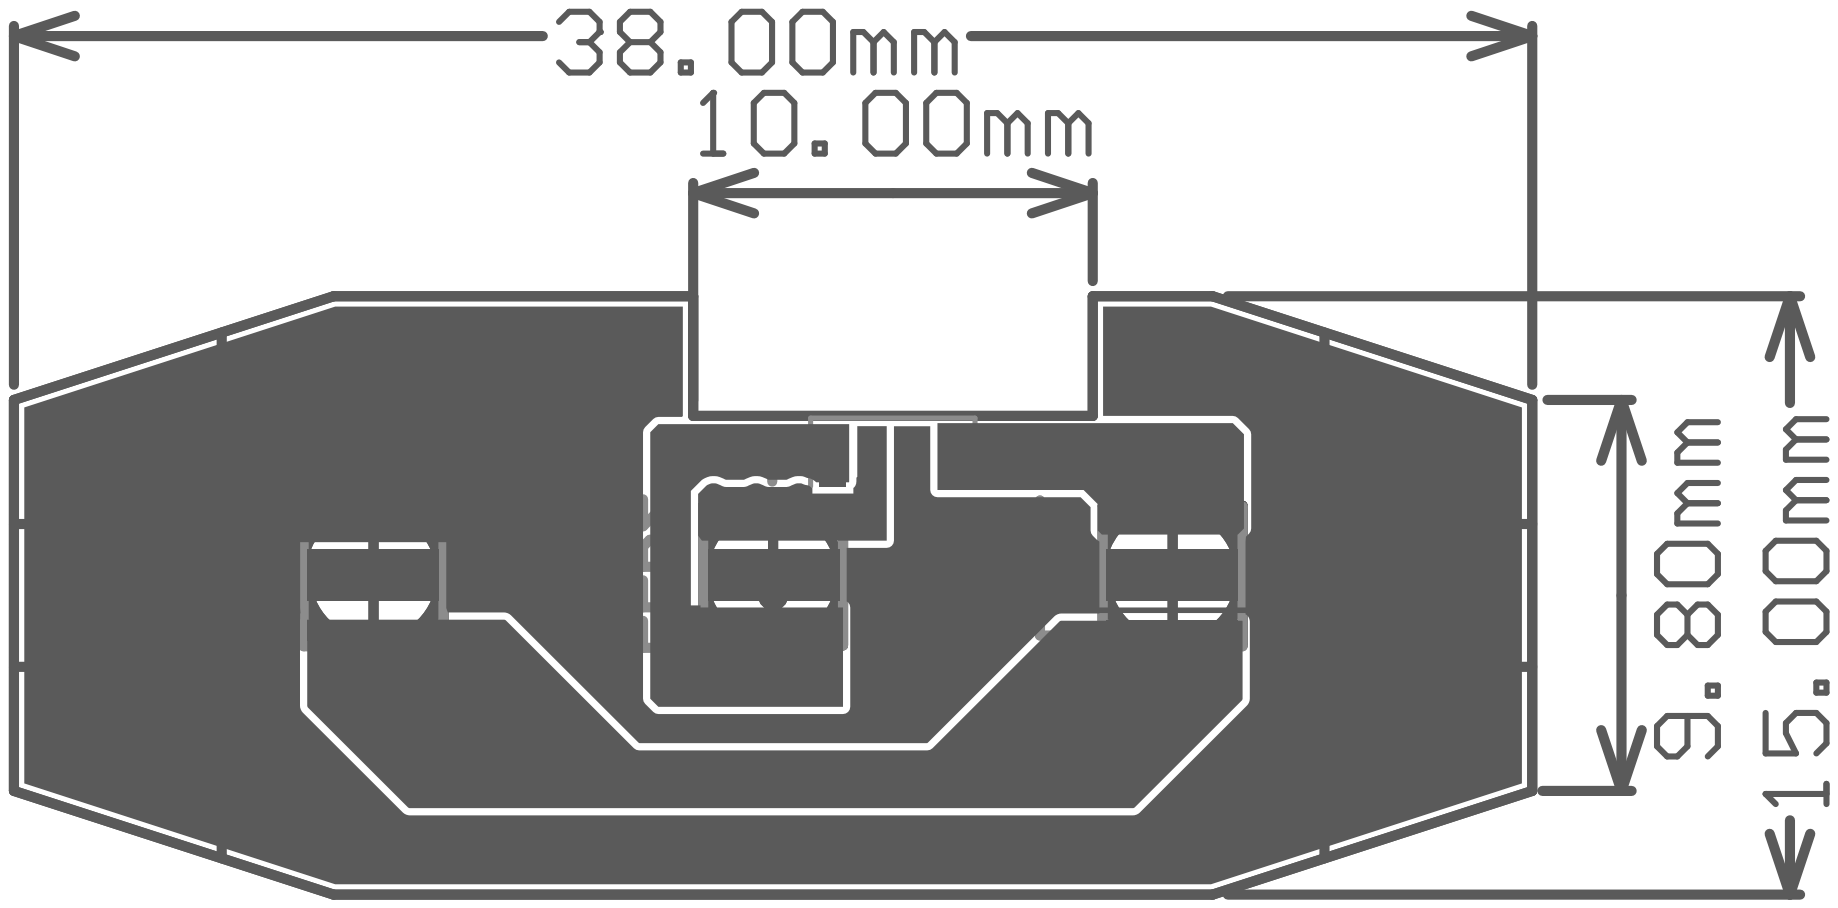
[picture p35: page 2]
