eSpark-Consulting-Group/brad-fairman-led-project/Design-Files/Button-Board_v2.0/Deliverables/Schematics/Asemmbly Drawing_v2.0.pdf

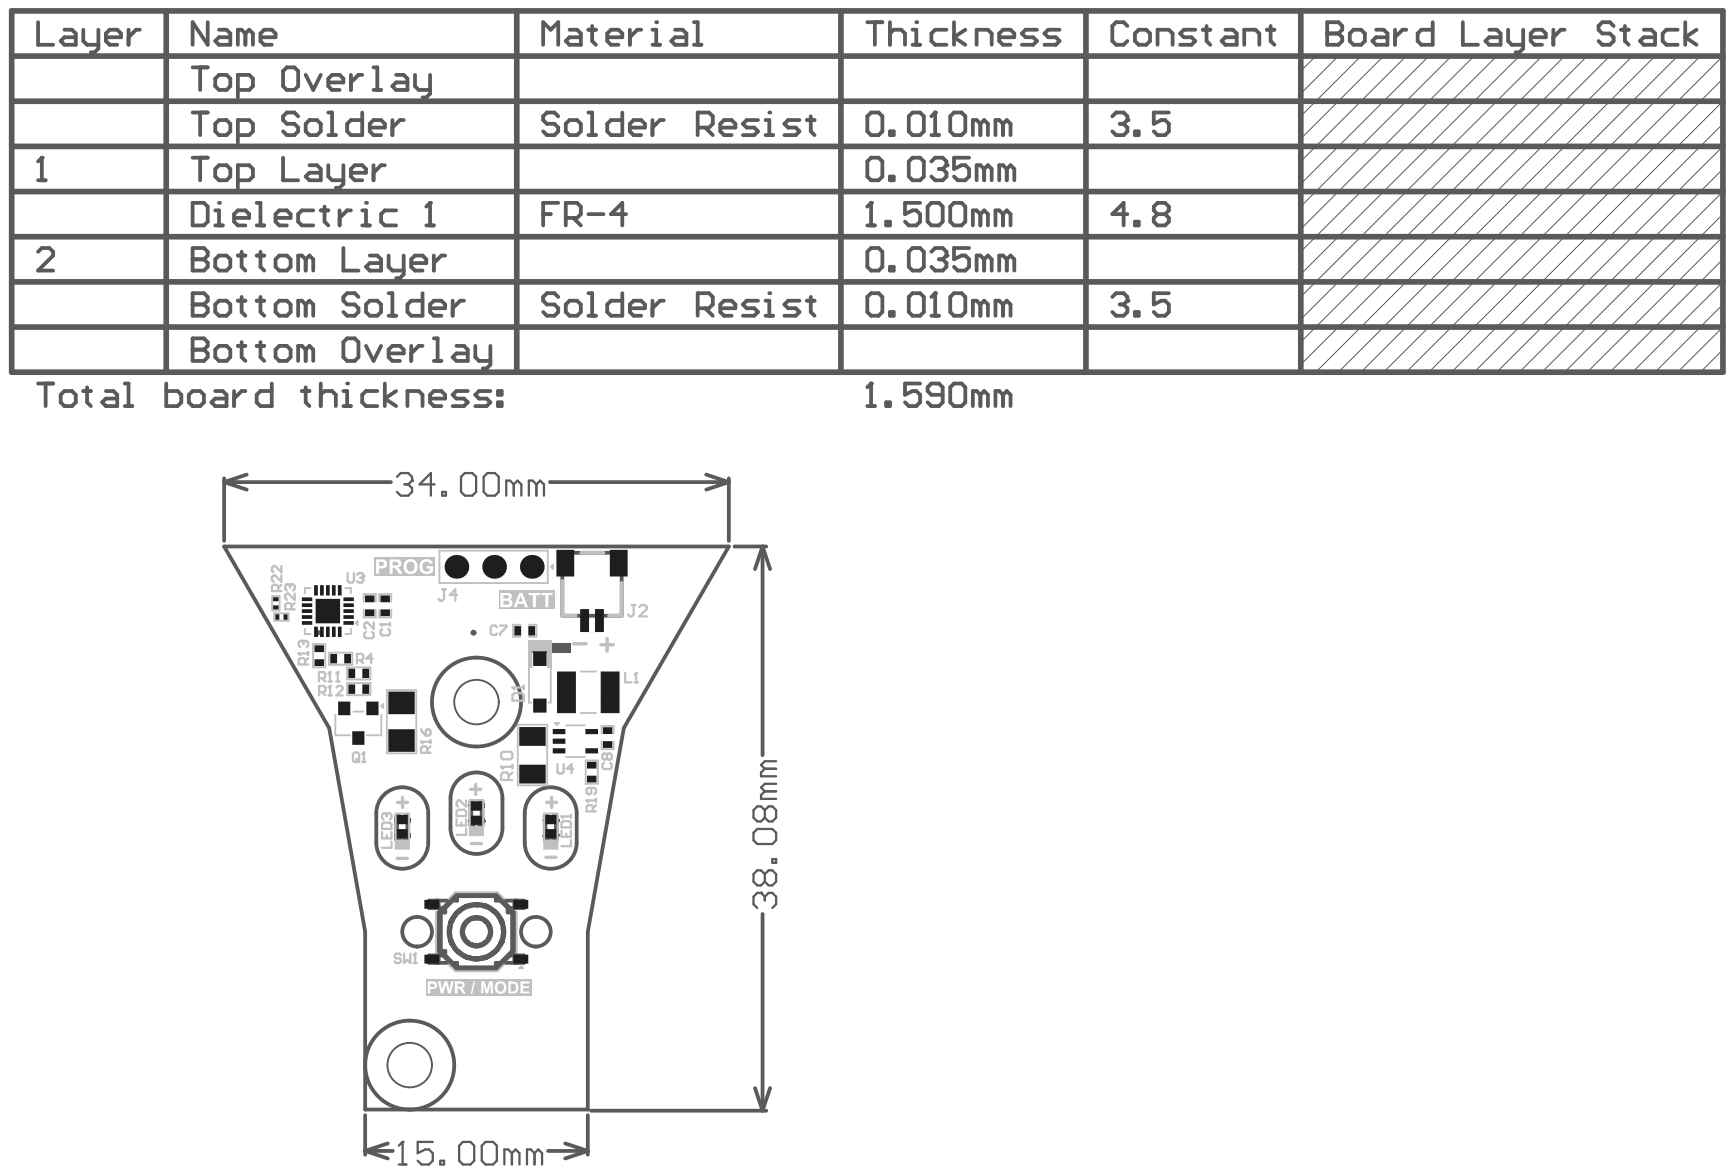
[picture p36: page 1]

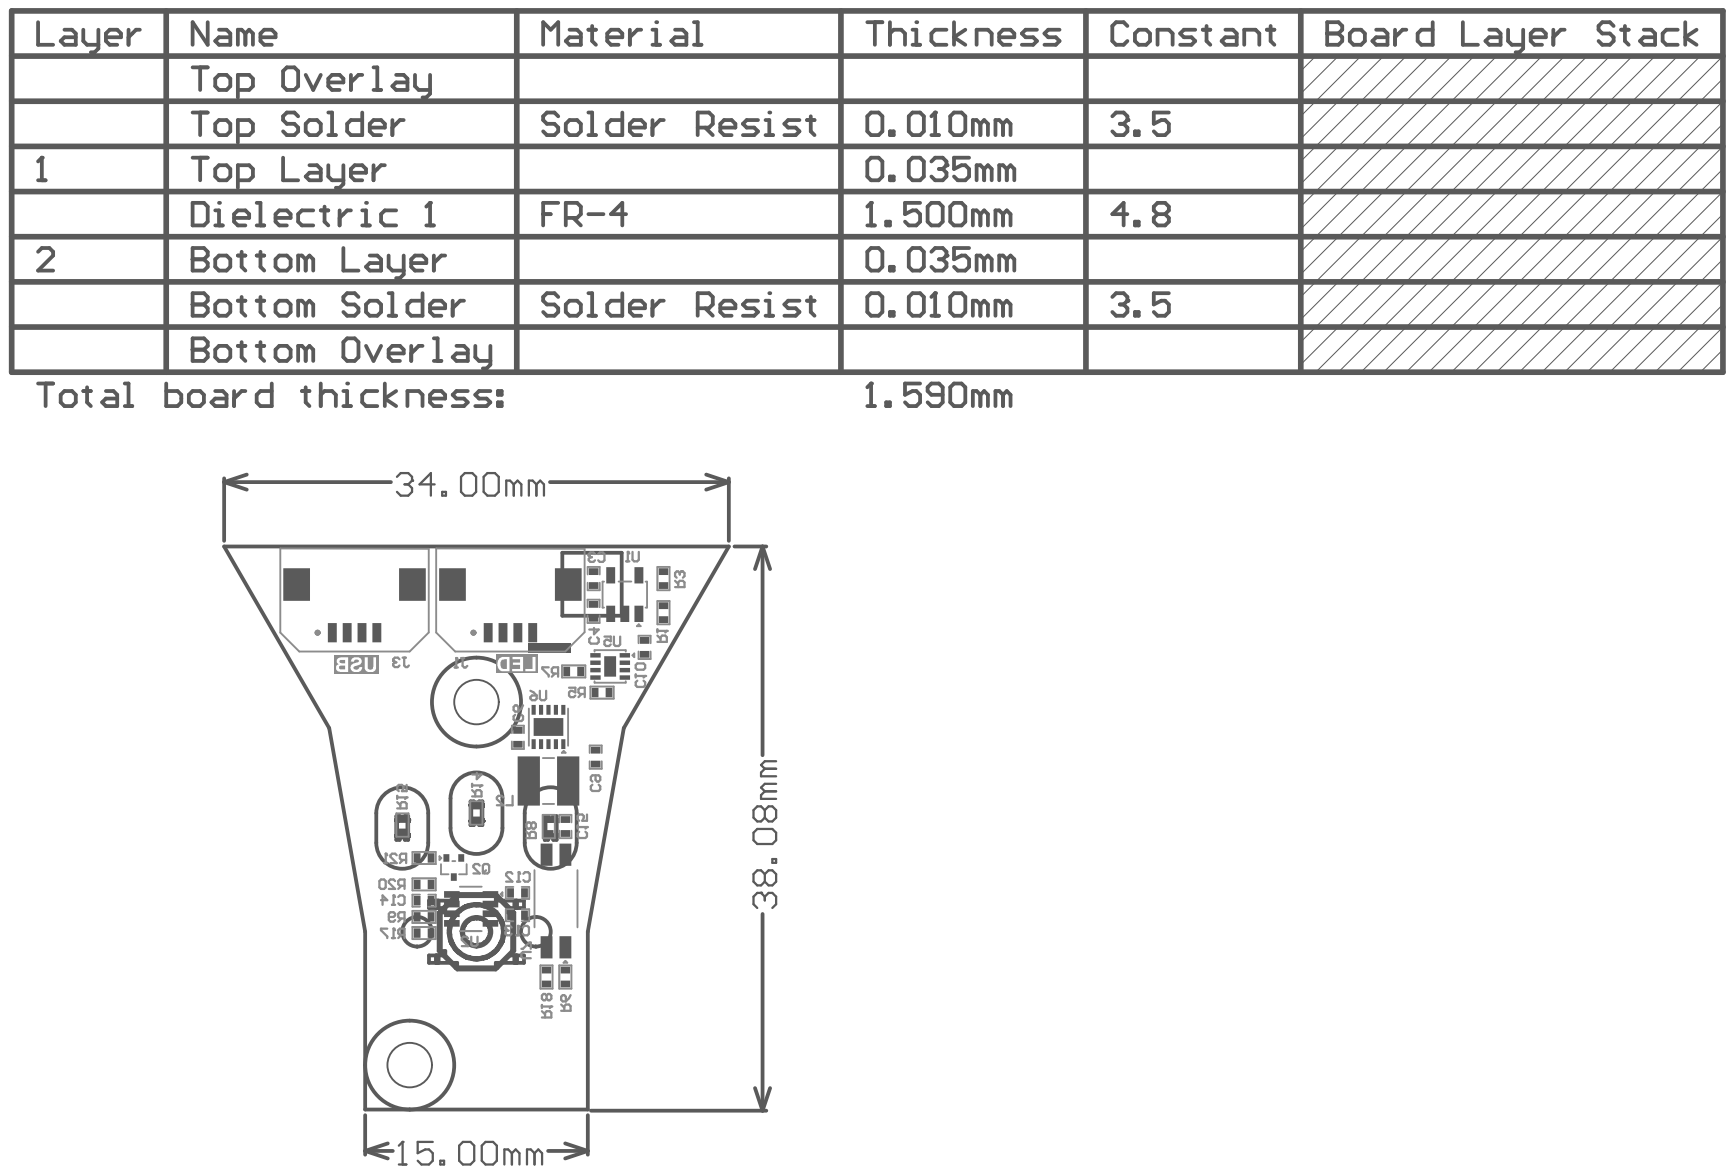
[picture p37: page 2]
