eSpark-Consulting-Group/brad-fairman-led-project/Design-Files/Flex-Cable-LED Board_v2.0/Deliverables/Schematics/Assembly Drawings_v2.0.pdf

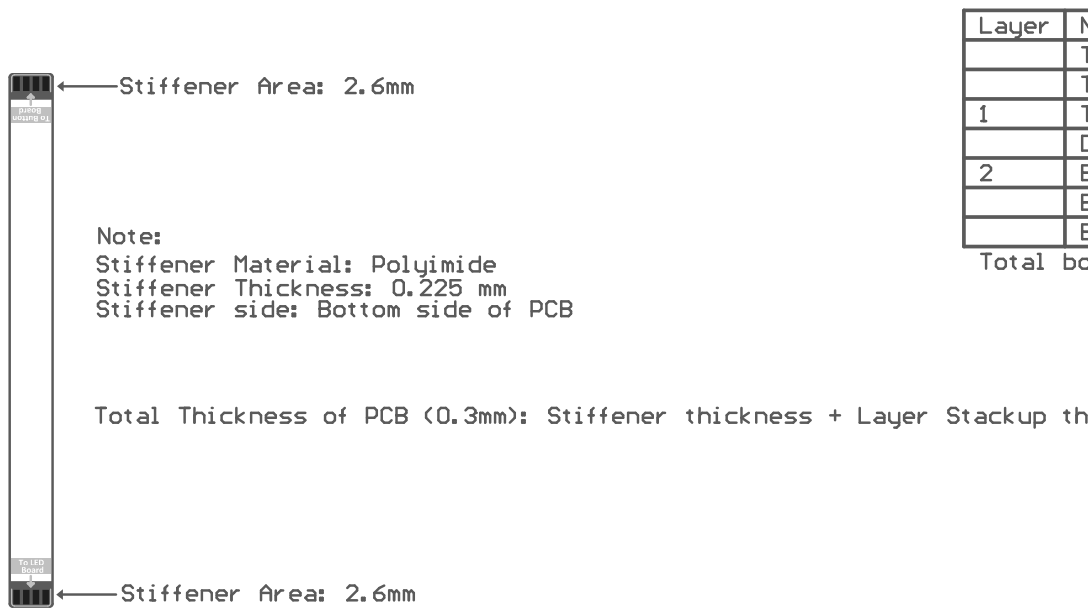
[picture p38: page 1]

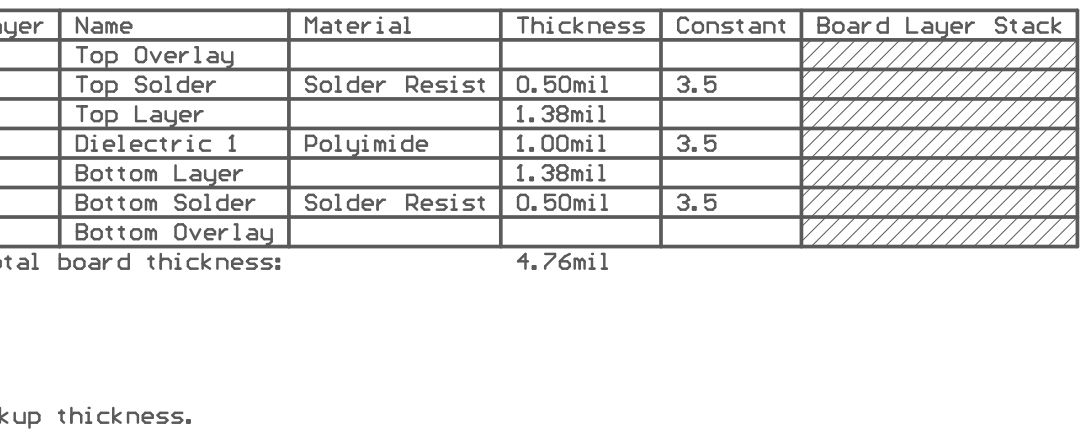
[picture p39: page 2]

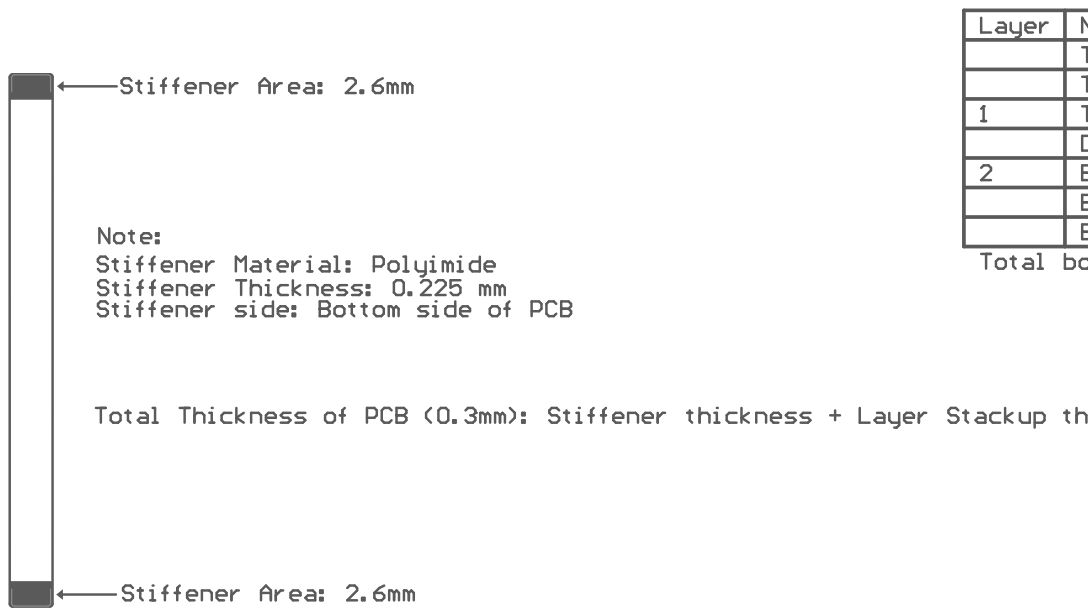
[picture p40: page 3]
