eSpark-Consulting-Group/brad-fairman-led-project/Design-Files/Flex-Cable-LED Board_v2.0/Deliverables/Schematics/Schematic_Flex-LED-Board_v2.0.pdf

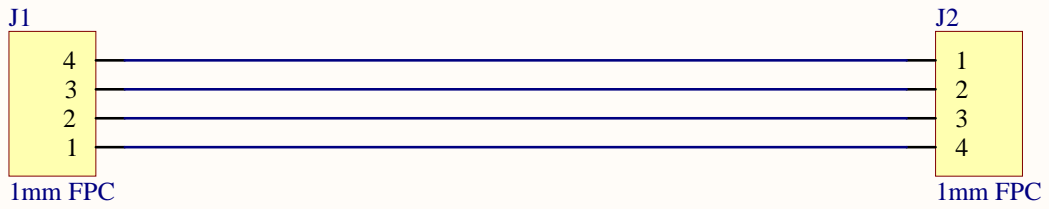
[picture p41: page 1]
