eSpark-Consulting-Group/brad-fairman-led-project/Design-Files/Flex-Cable-USB_v2.0/Deliverables/Schematics/Assembly Drawings_v1.0.pdf

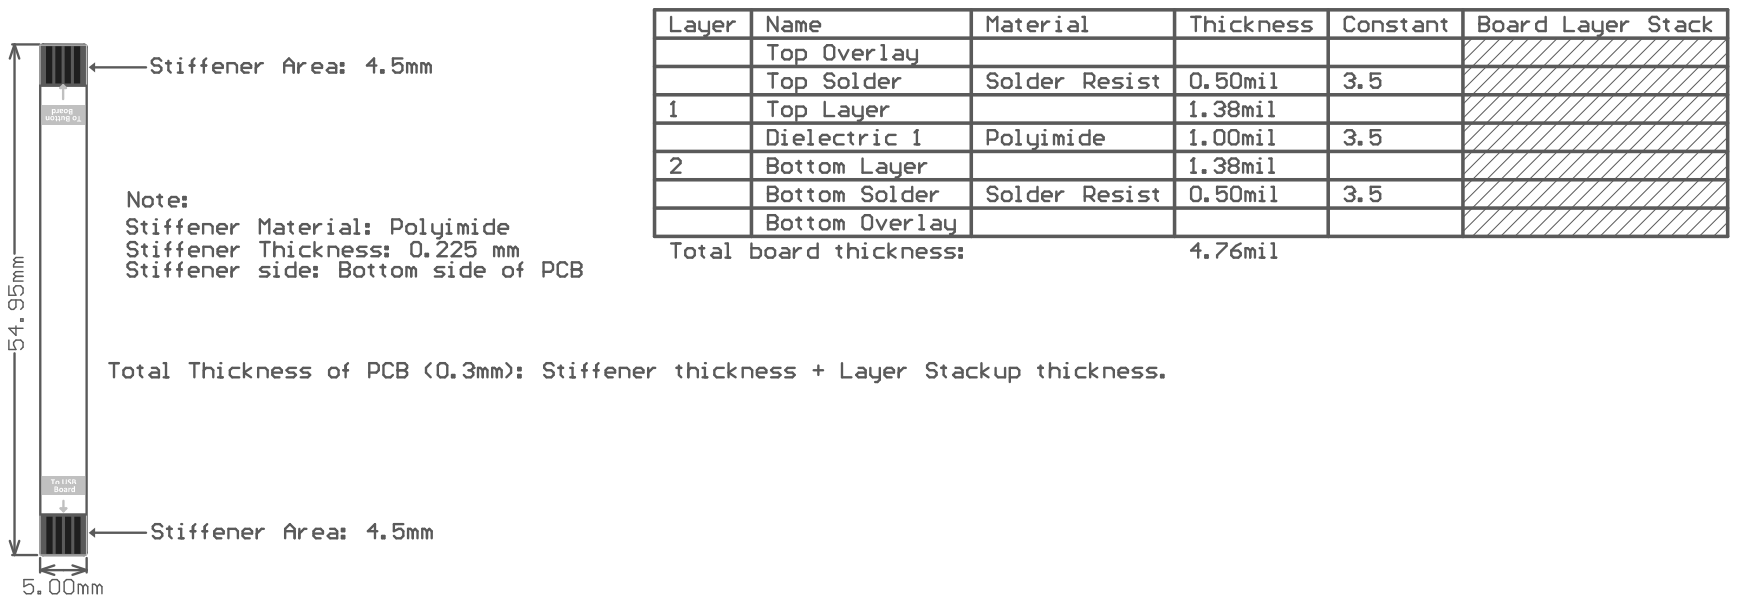
[picture p42: page 1]

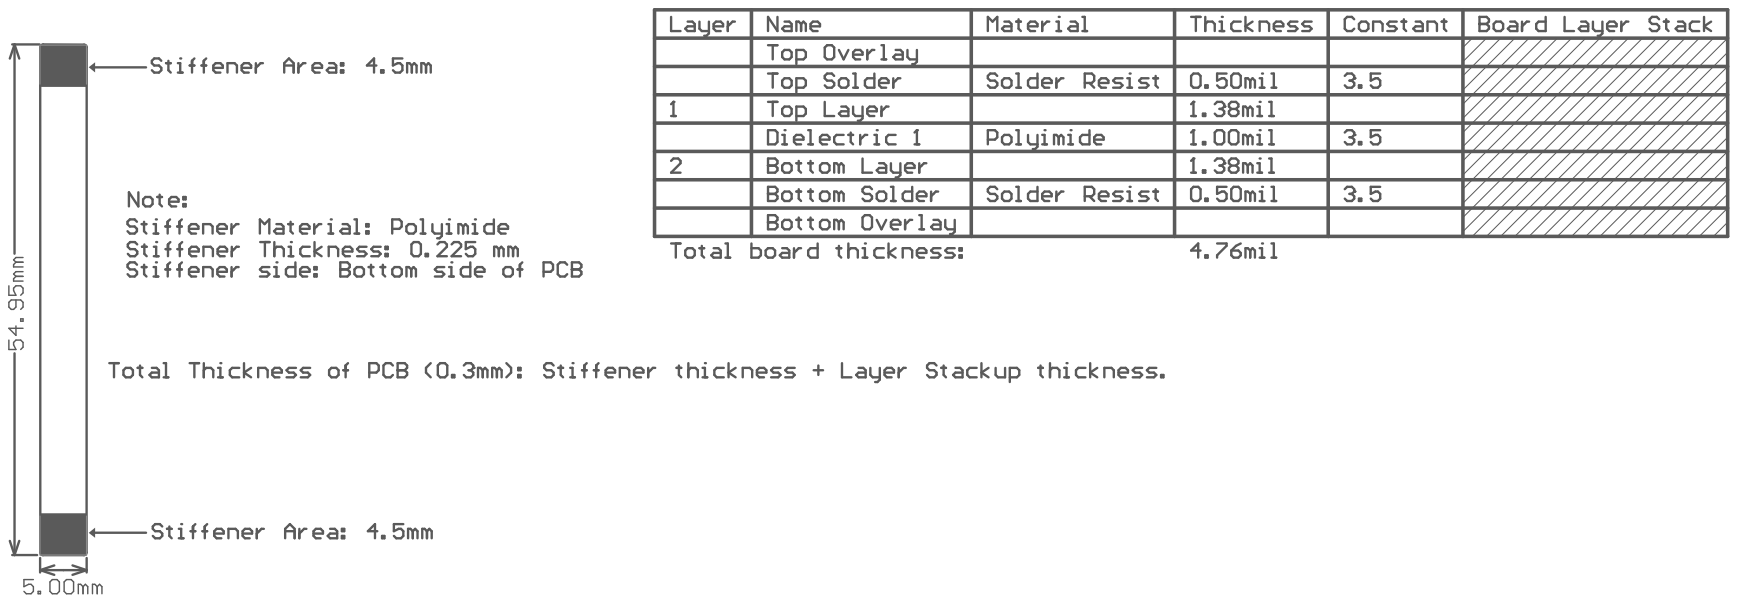
[picture p43: page 2]
