eSpark-Consulting-Group/brad-fairman-led-project/Design-Files/Flex-Cable-USB_v2.0/Deliverables/Schematics/Flex-USB_v1.0.pdf

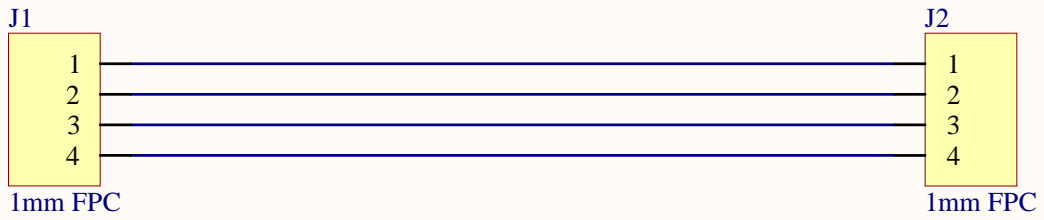
[picture p44: page 1]
