eSpark-Consulting-Group/brad-fairman-led-project/Design-Files/USB-Board_v2.0/Deliverables/Schematics/Assembly_Drawings_v2.0.pdf

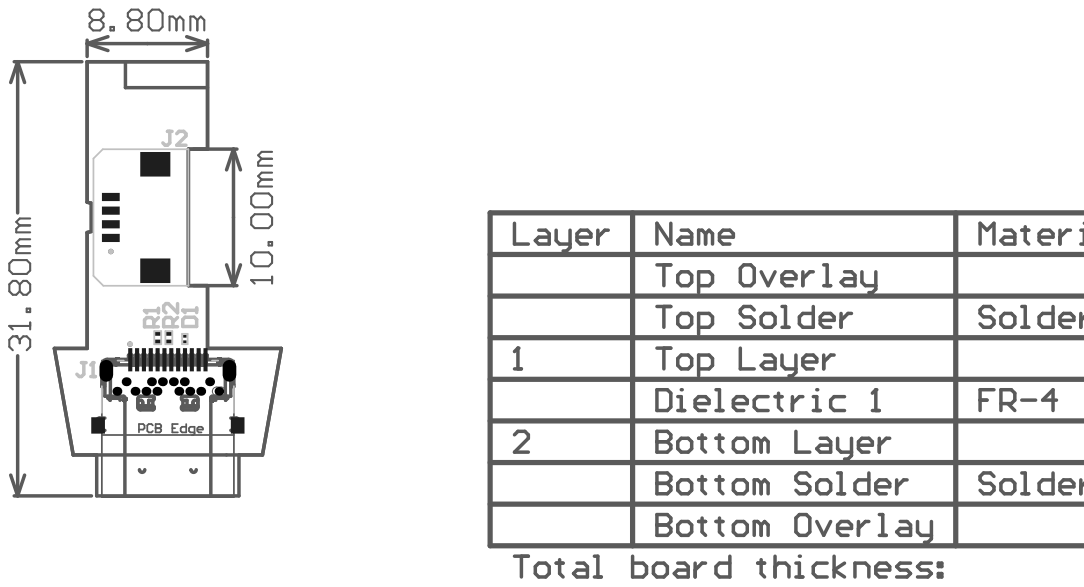
[picture p45: page 1]

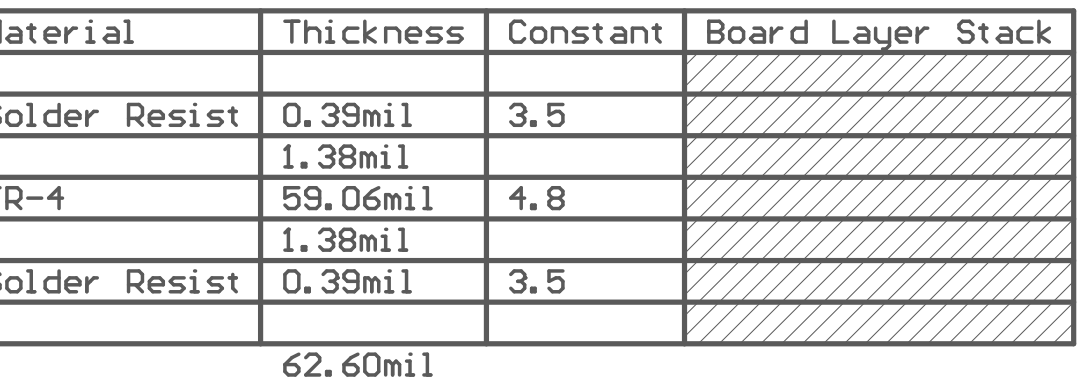
[picture p46: page 2]

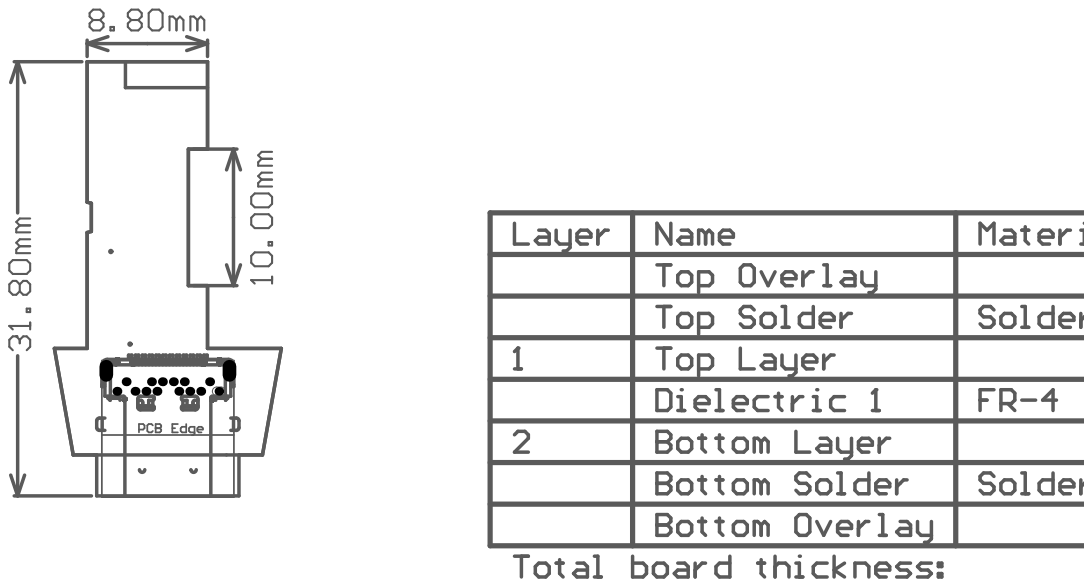
[picture p47: page 3]
