eSpark-Consulting-Group/brad-fairman-led-project/Design-Files/USB-Board_v2.0/Deliverables/Schematics/Schematic_USB_Board_v2.0.pdf

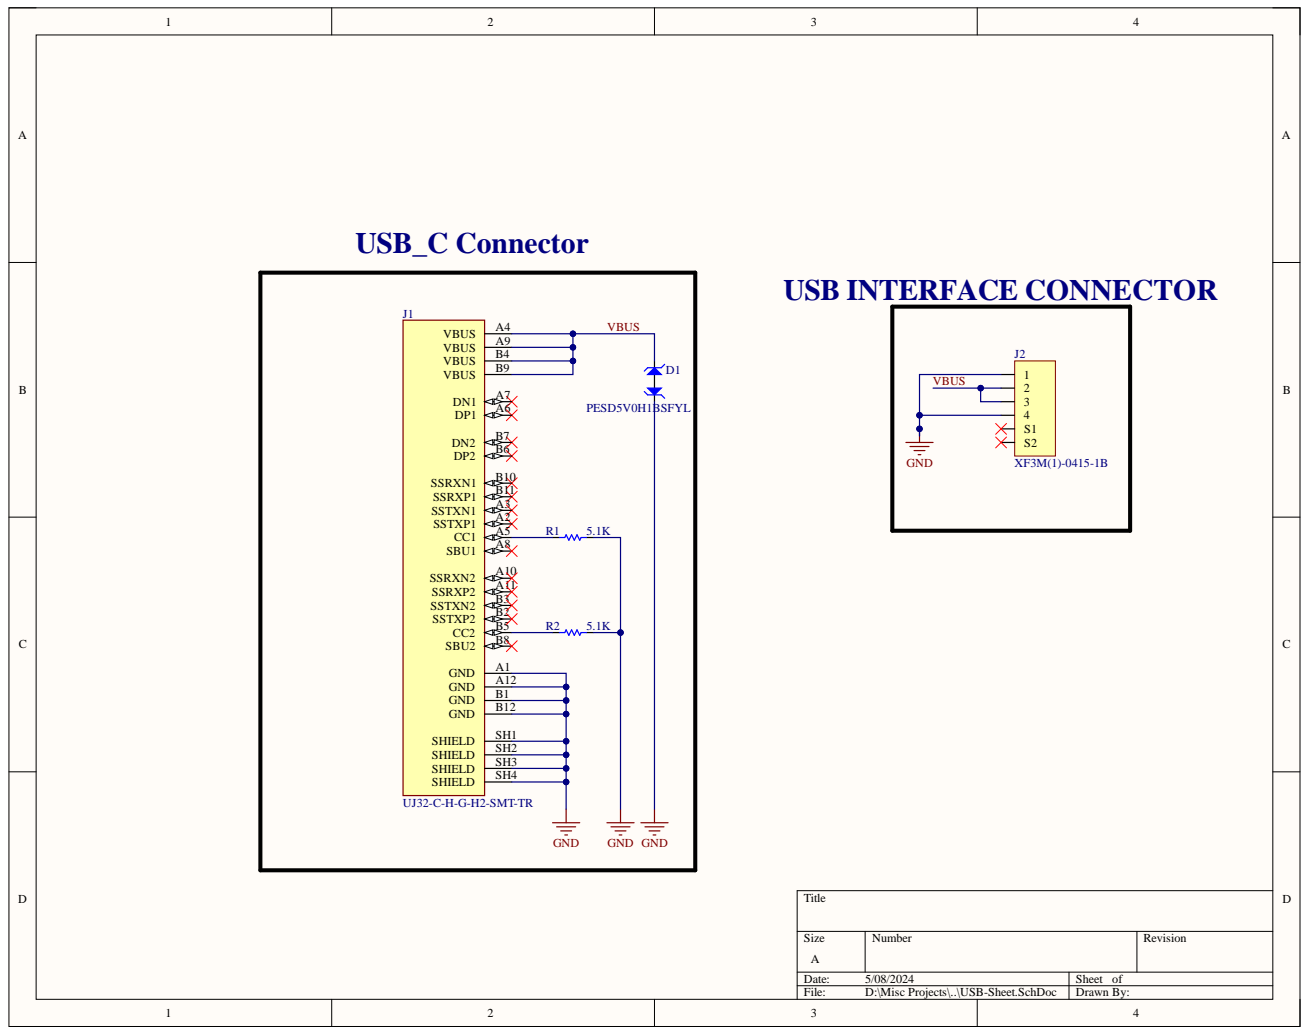
[picture p48: page 1]
