eSpark-Consulting-Group/brad-fairman-led-project/Design-Files/Button-Board_v1.0/Design File/Button-Board.pdf

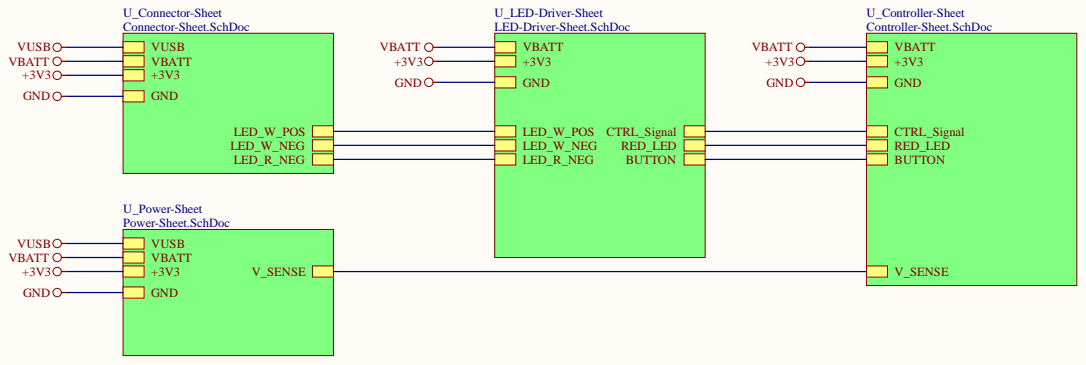
[picture p49: page 1]

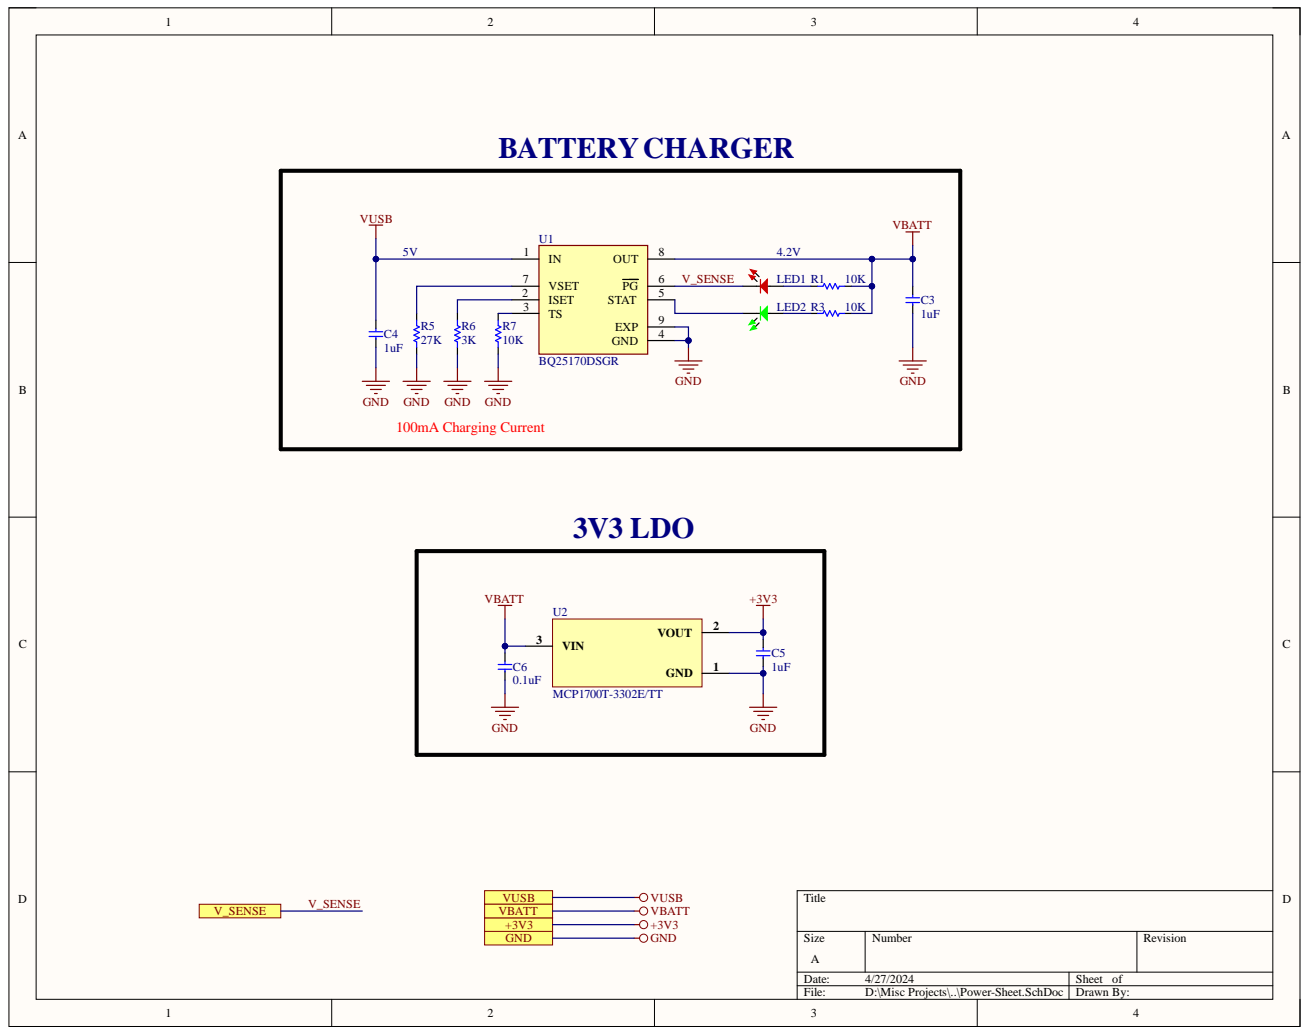
[picture p50: page 2]

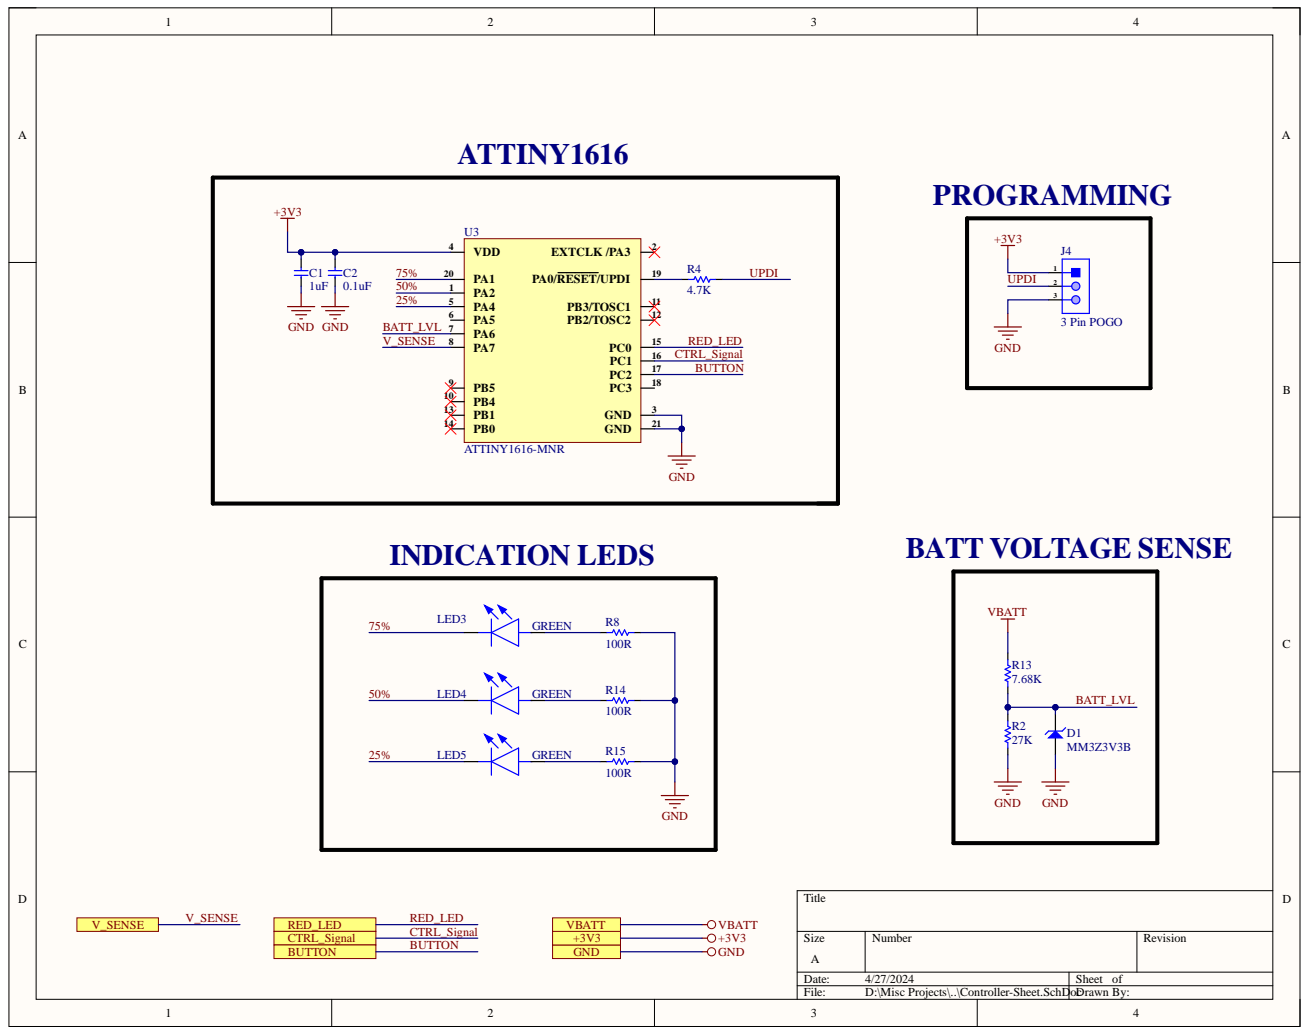
[picture p51: page 3]

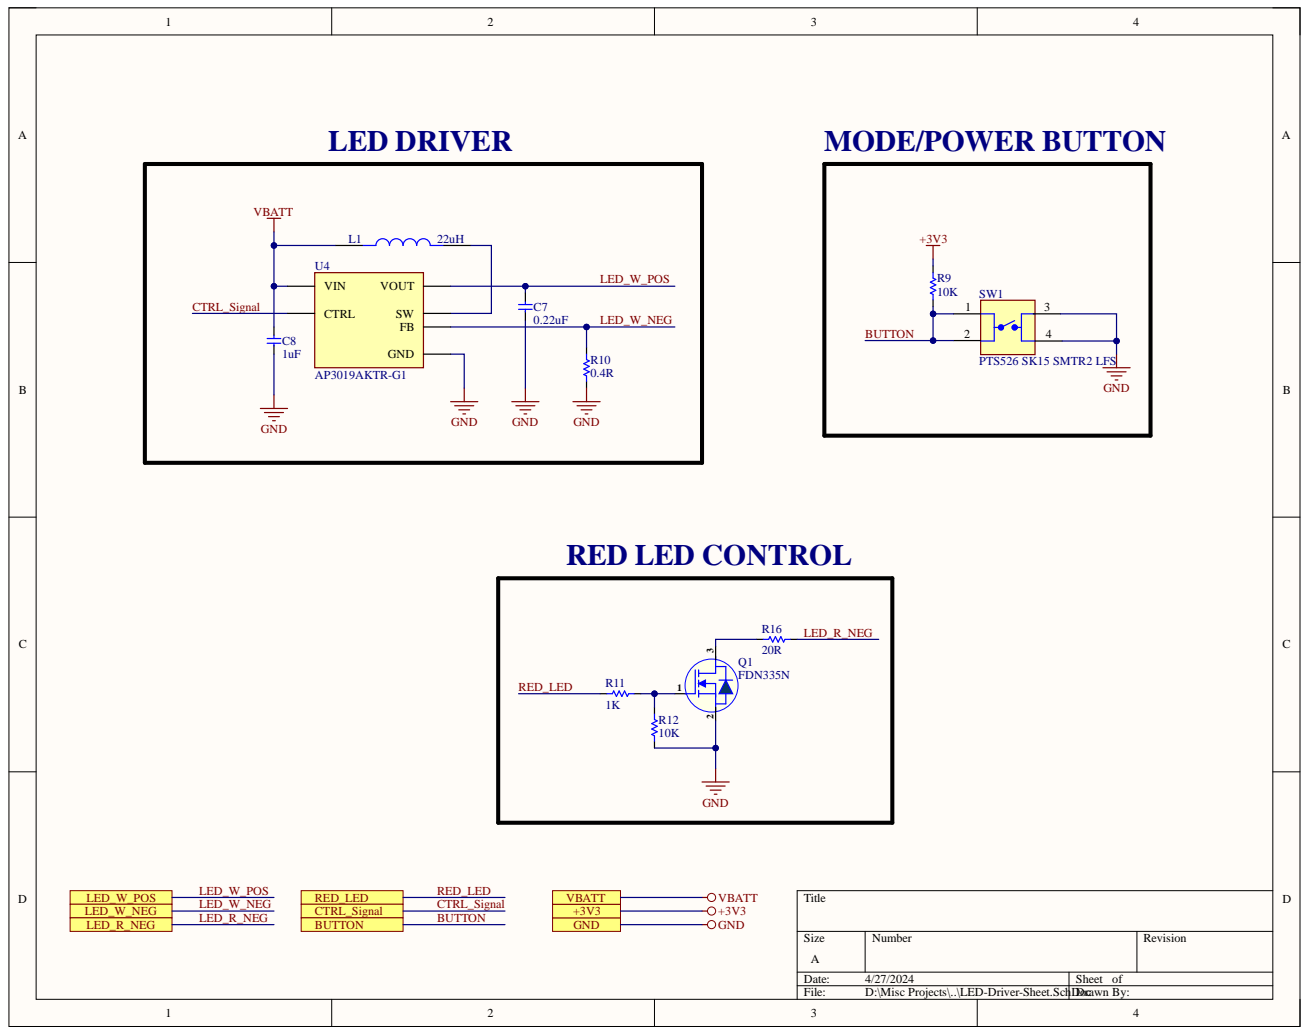
[picture p52: page 4]

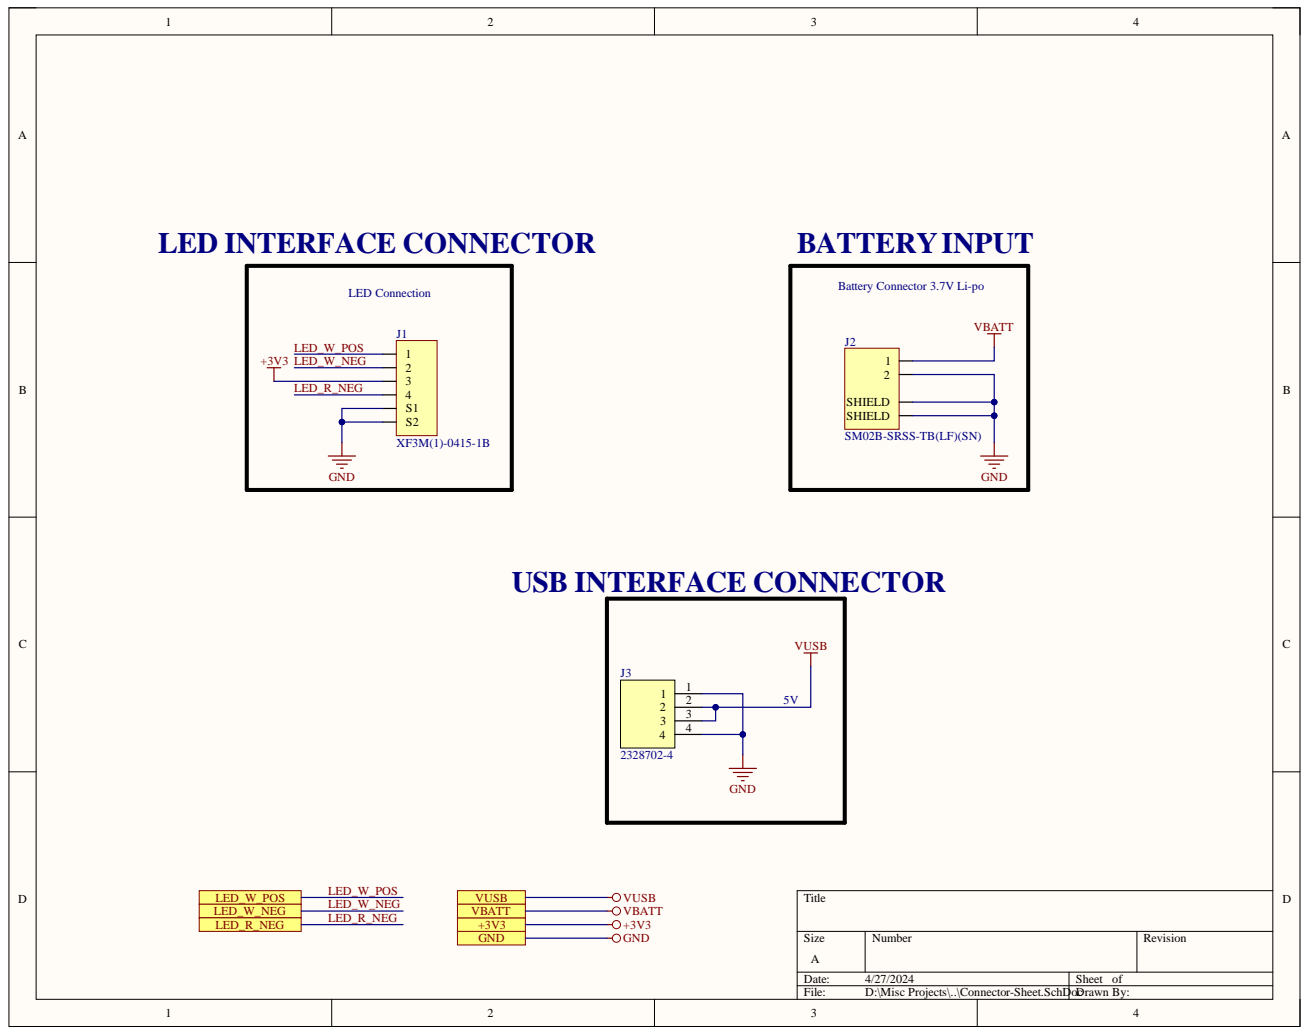
[picture p53: page 5]

Battery Connector 3.7V Li-po

SHIELD
SM02B-SRSS-TB(LF)(SN)
