eSpark-Consulting-Group/brad-fairman-led-project/Design-Files/Button-Board_v1.0/Deliverables/Schematics/Button-Board_v1.0.pdf

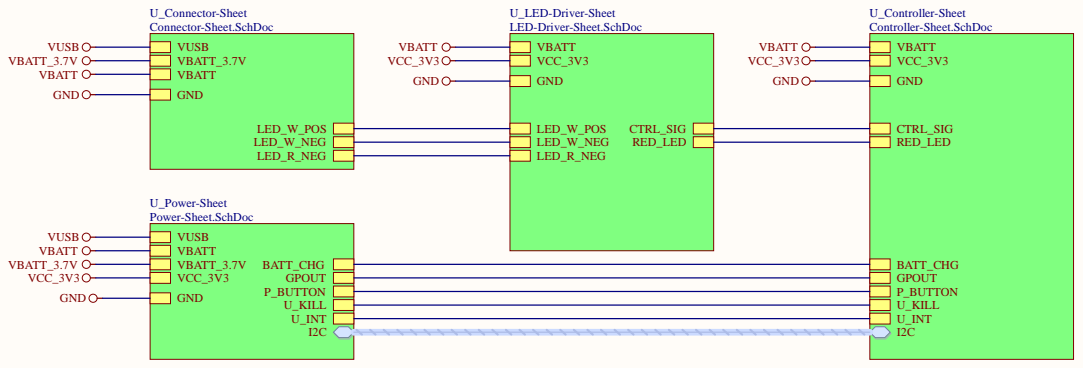
[picture p54: page 1]

Size A | Number | Revision

Date: 7/23/2024 | Sheet of
File: C:\Users\..\Top-Sheet.SchDoc | Drawn By:

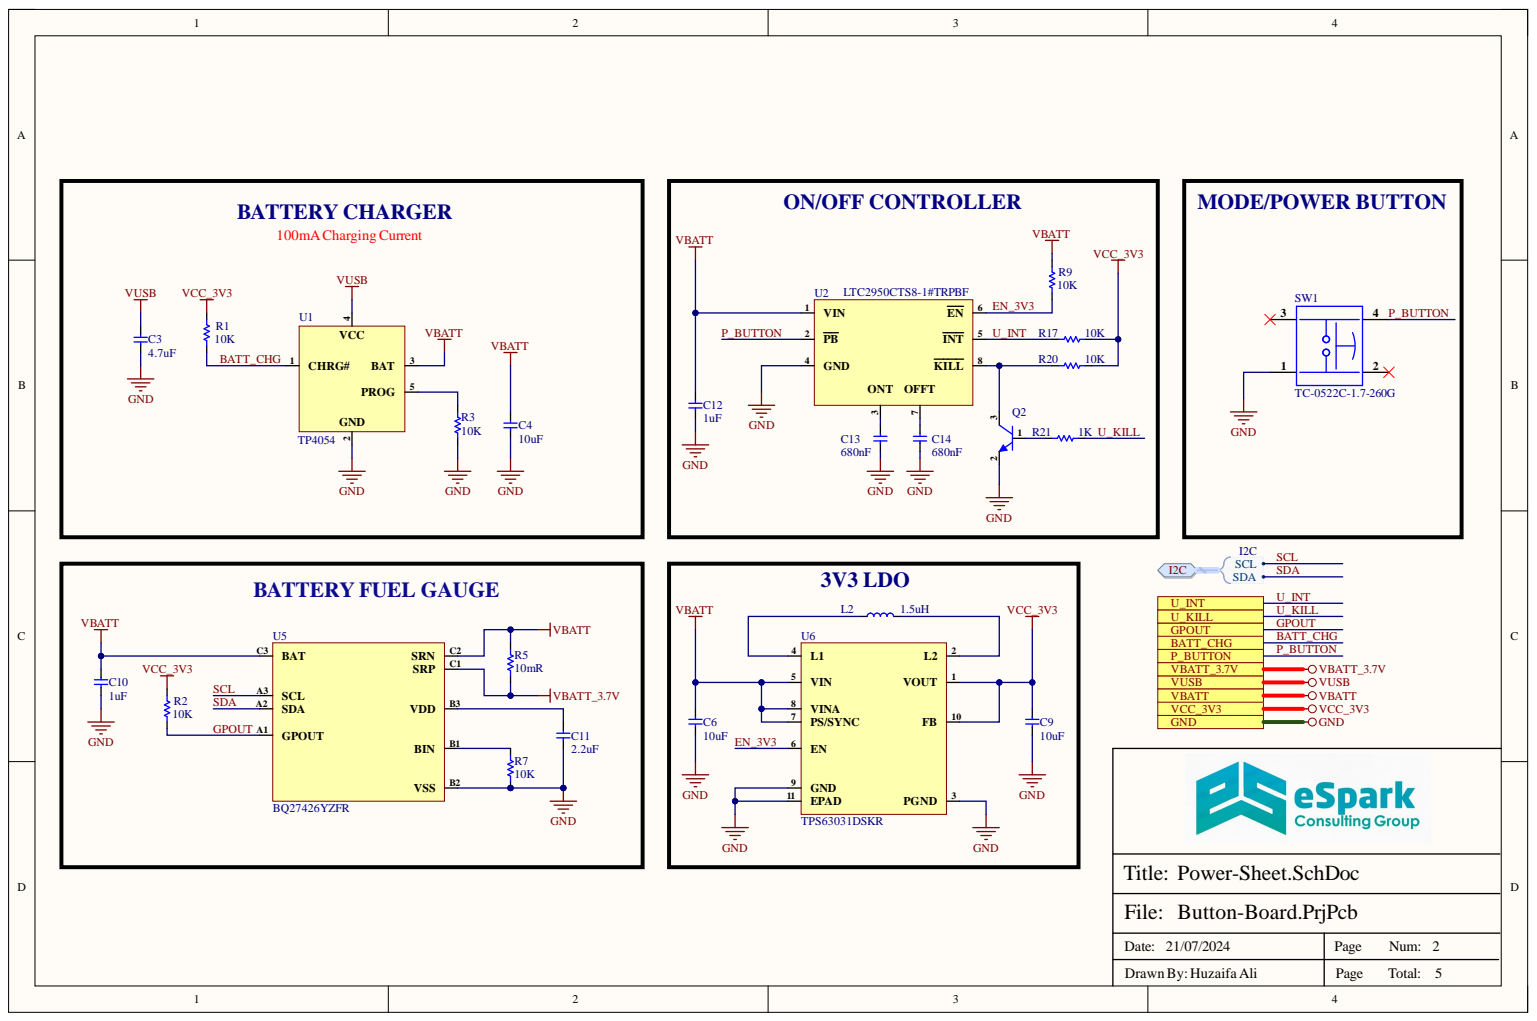
[picture p55: page 2]

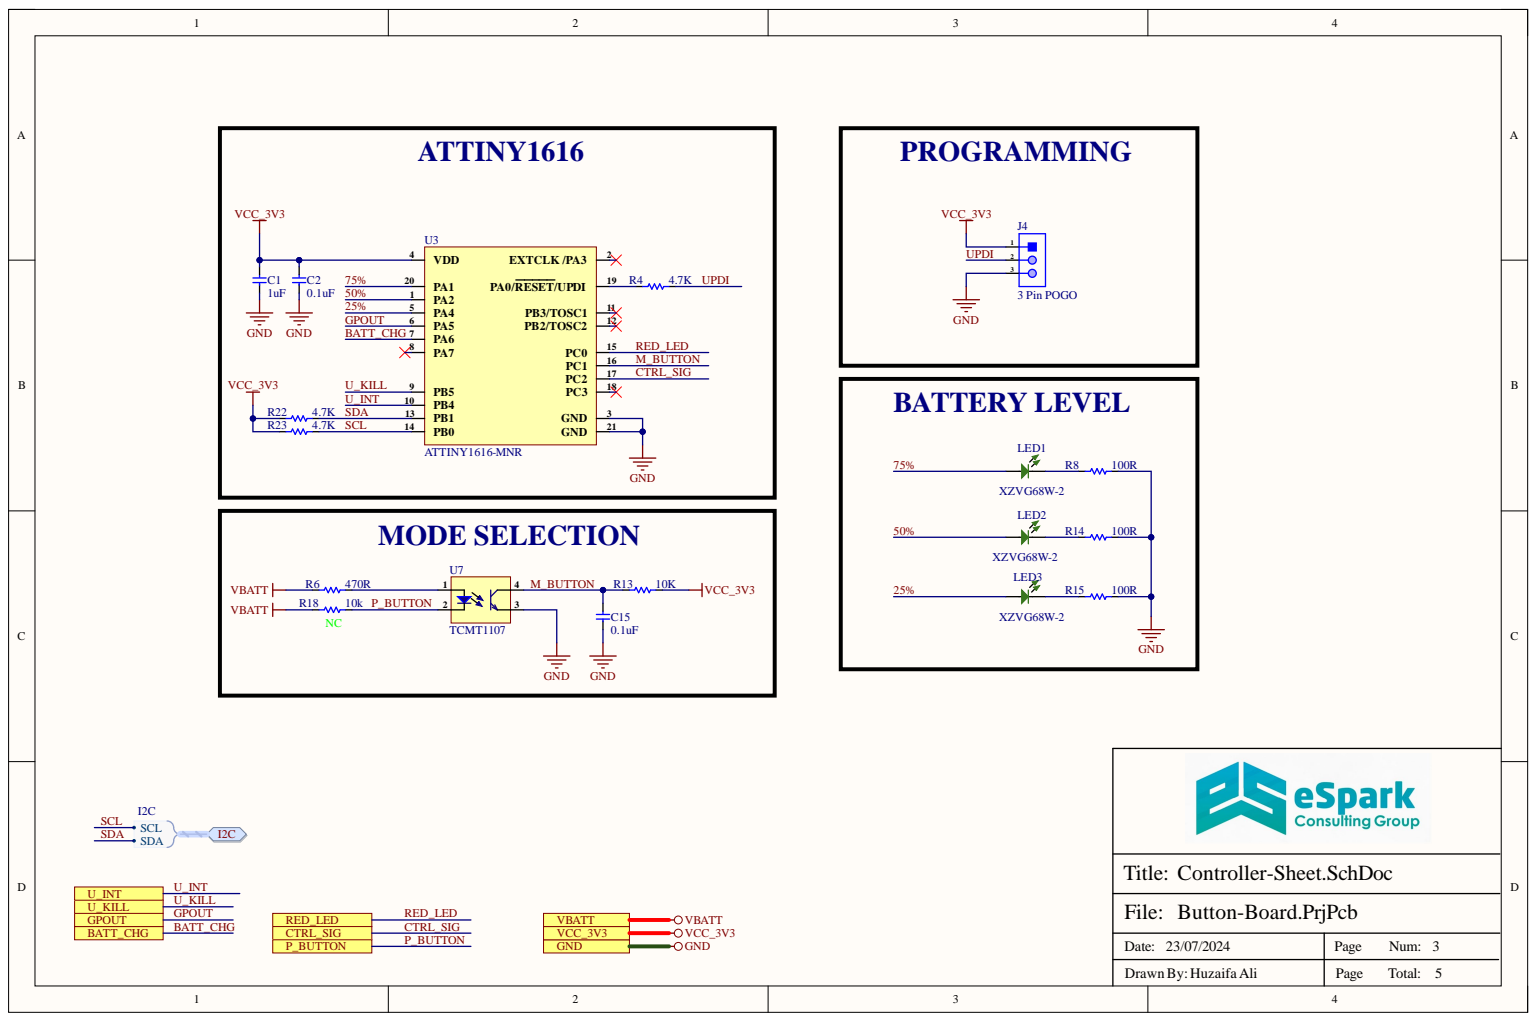
[picture p56: page 3]

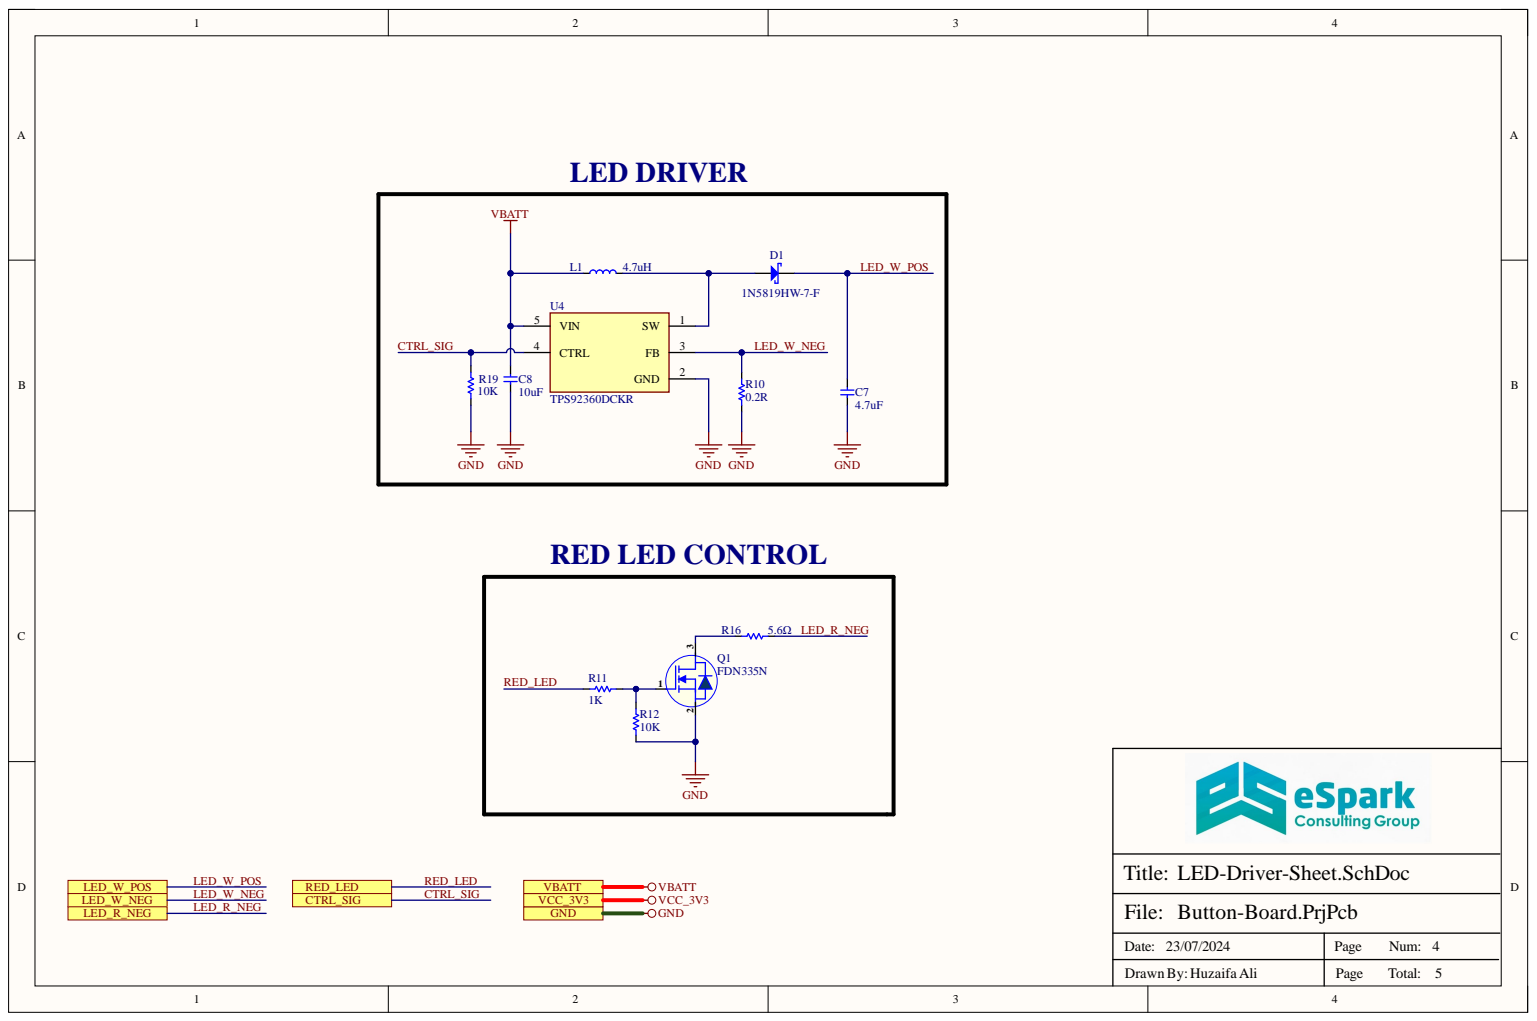
[picture p57: page 4]

LED-Driver-Sheet.SchDoc

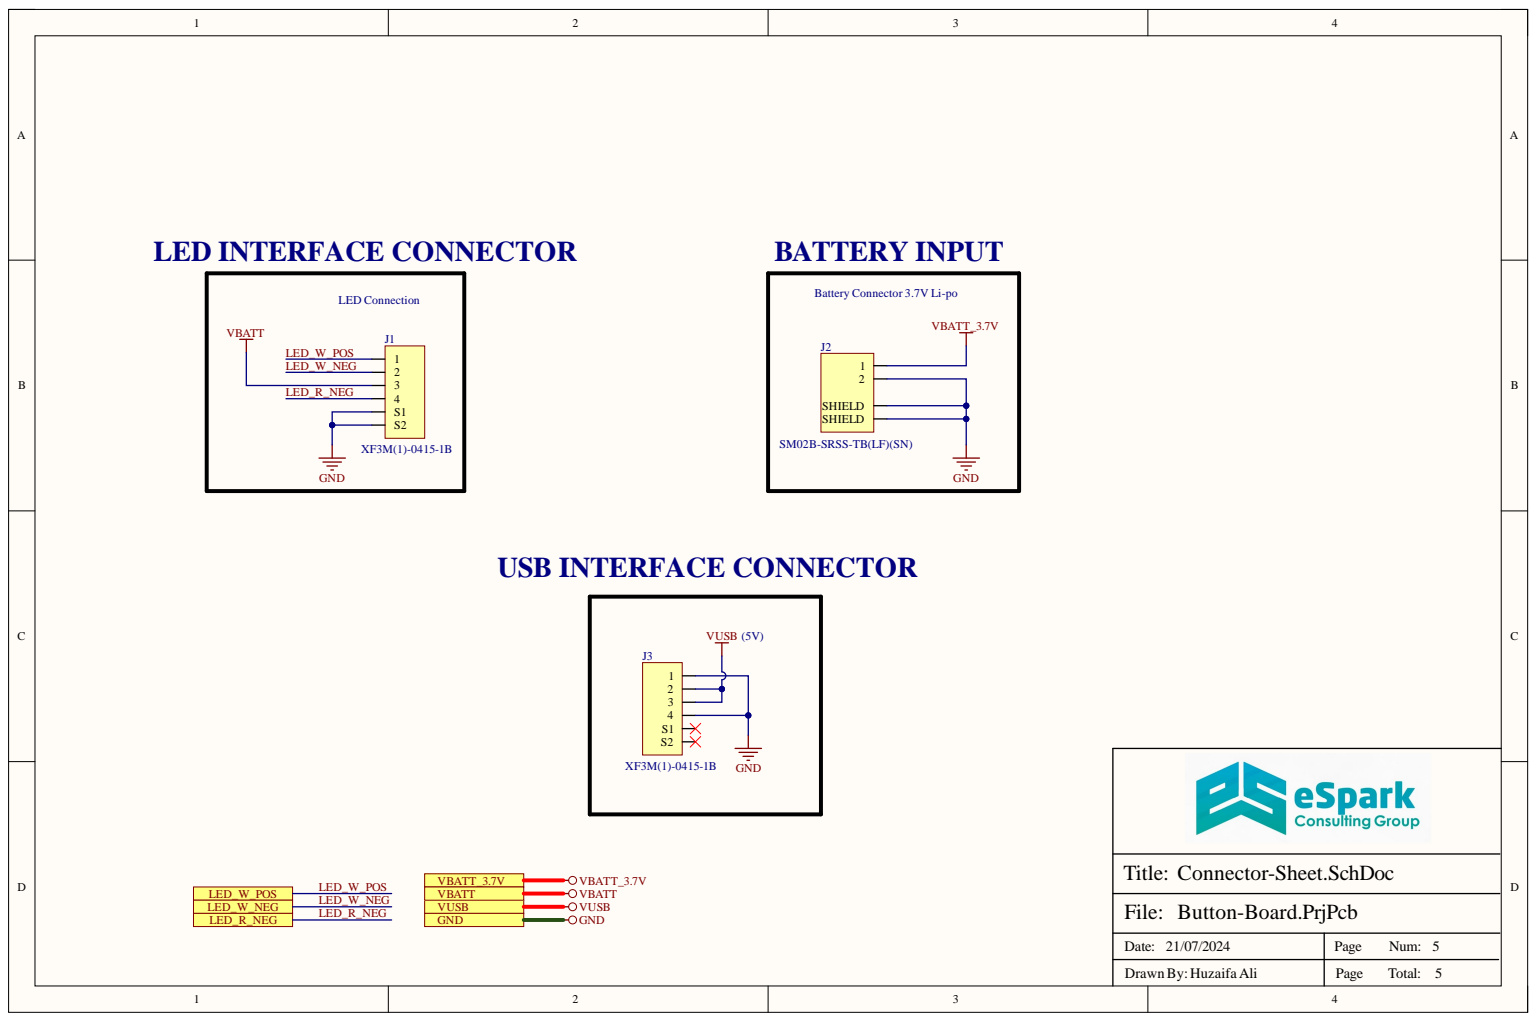
[picture p58: page 5]

Battery Connector 3.7V Li-po

SM02B-SRSS-TB(LF)(SN)

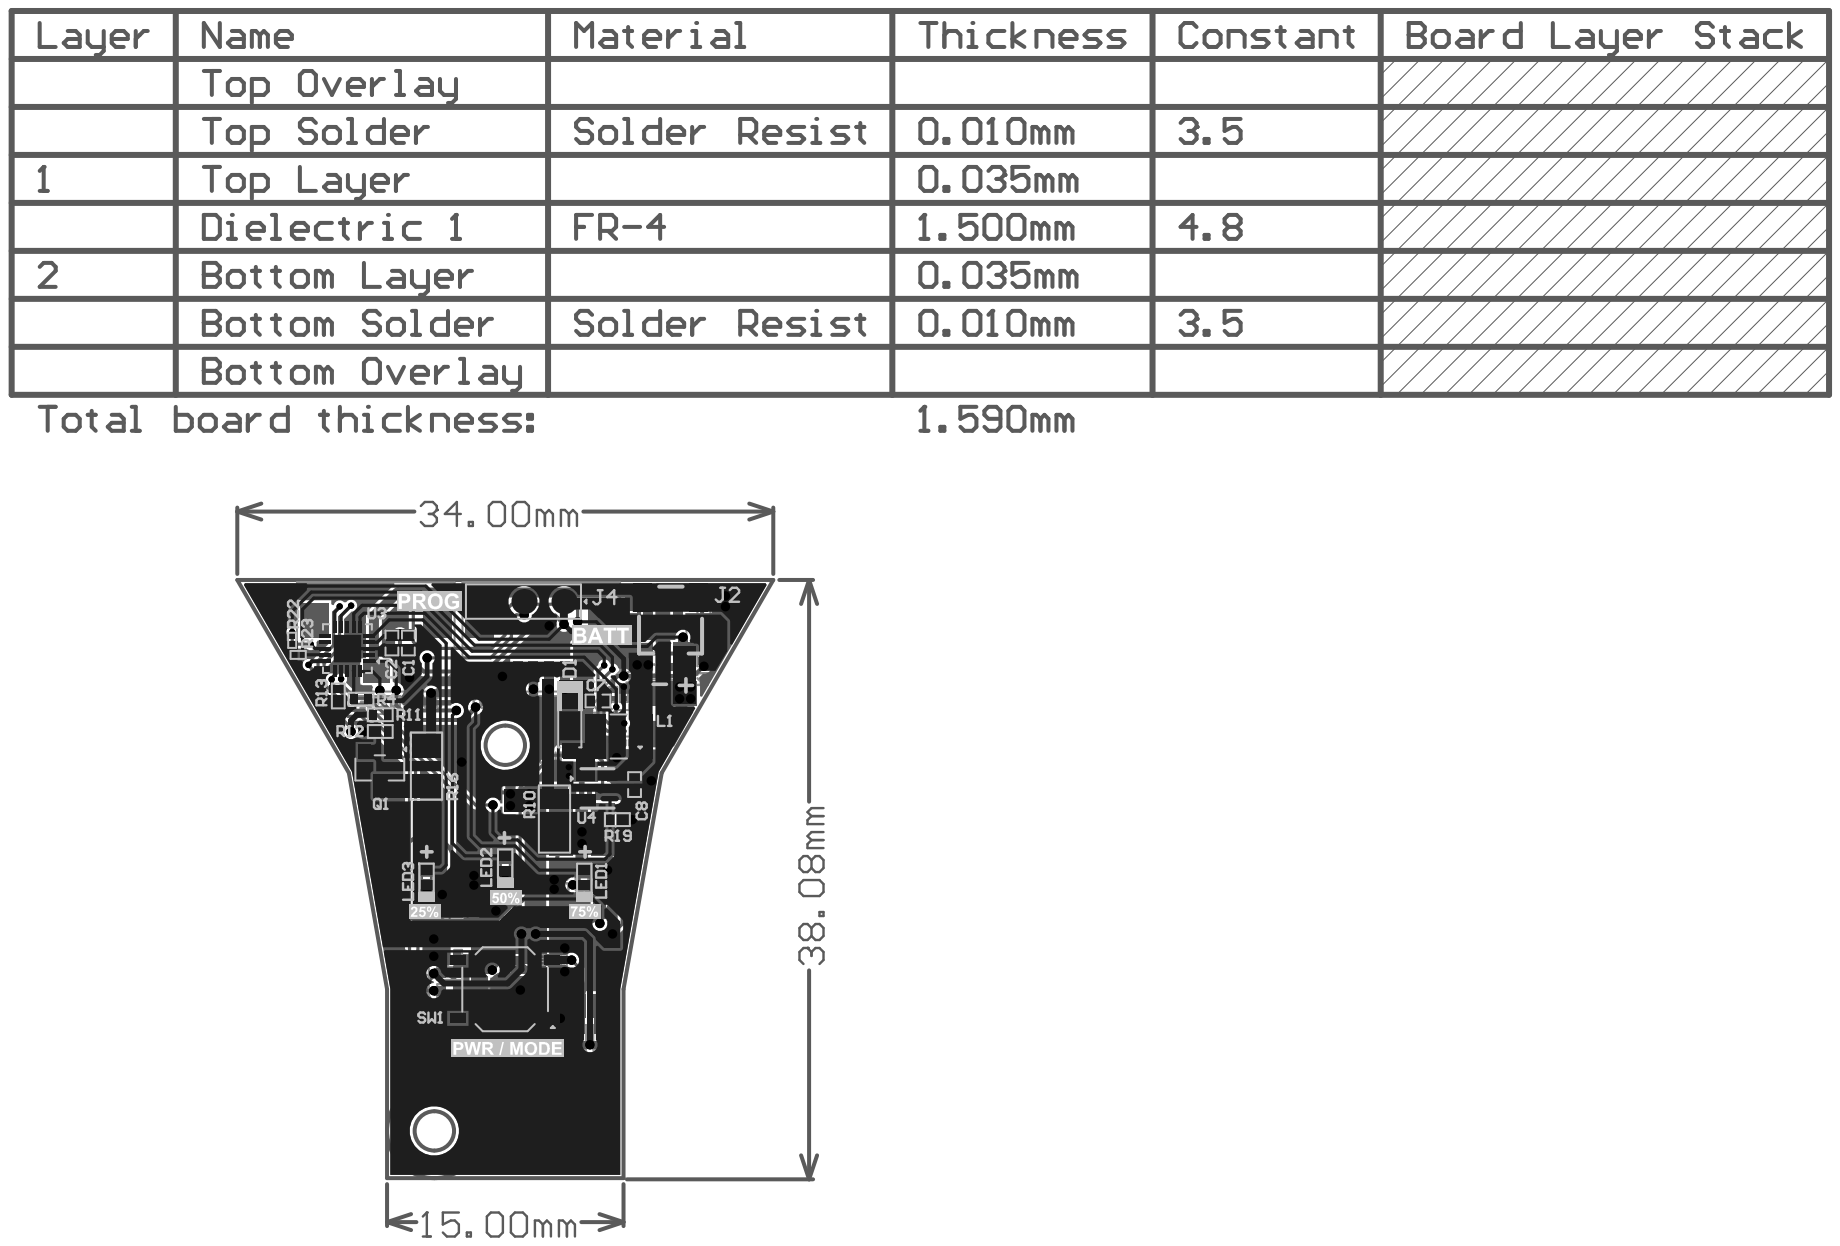
[picture p59: page 6]
