eSpark-Consulting-Group/brad-fairman-led-project/Design-Files/Button-Board_v1.0/Deliverables/Schematics/Asemmbly Drawing_v1.0.pdf

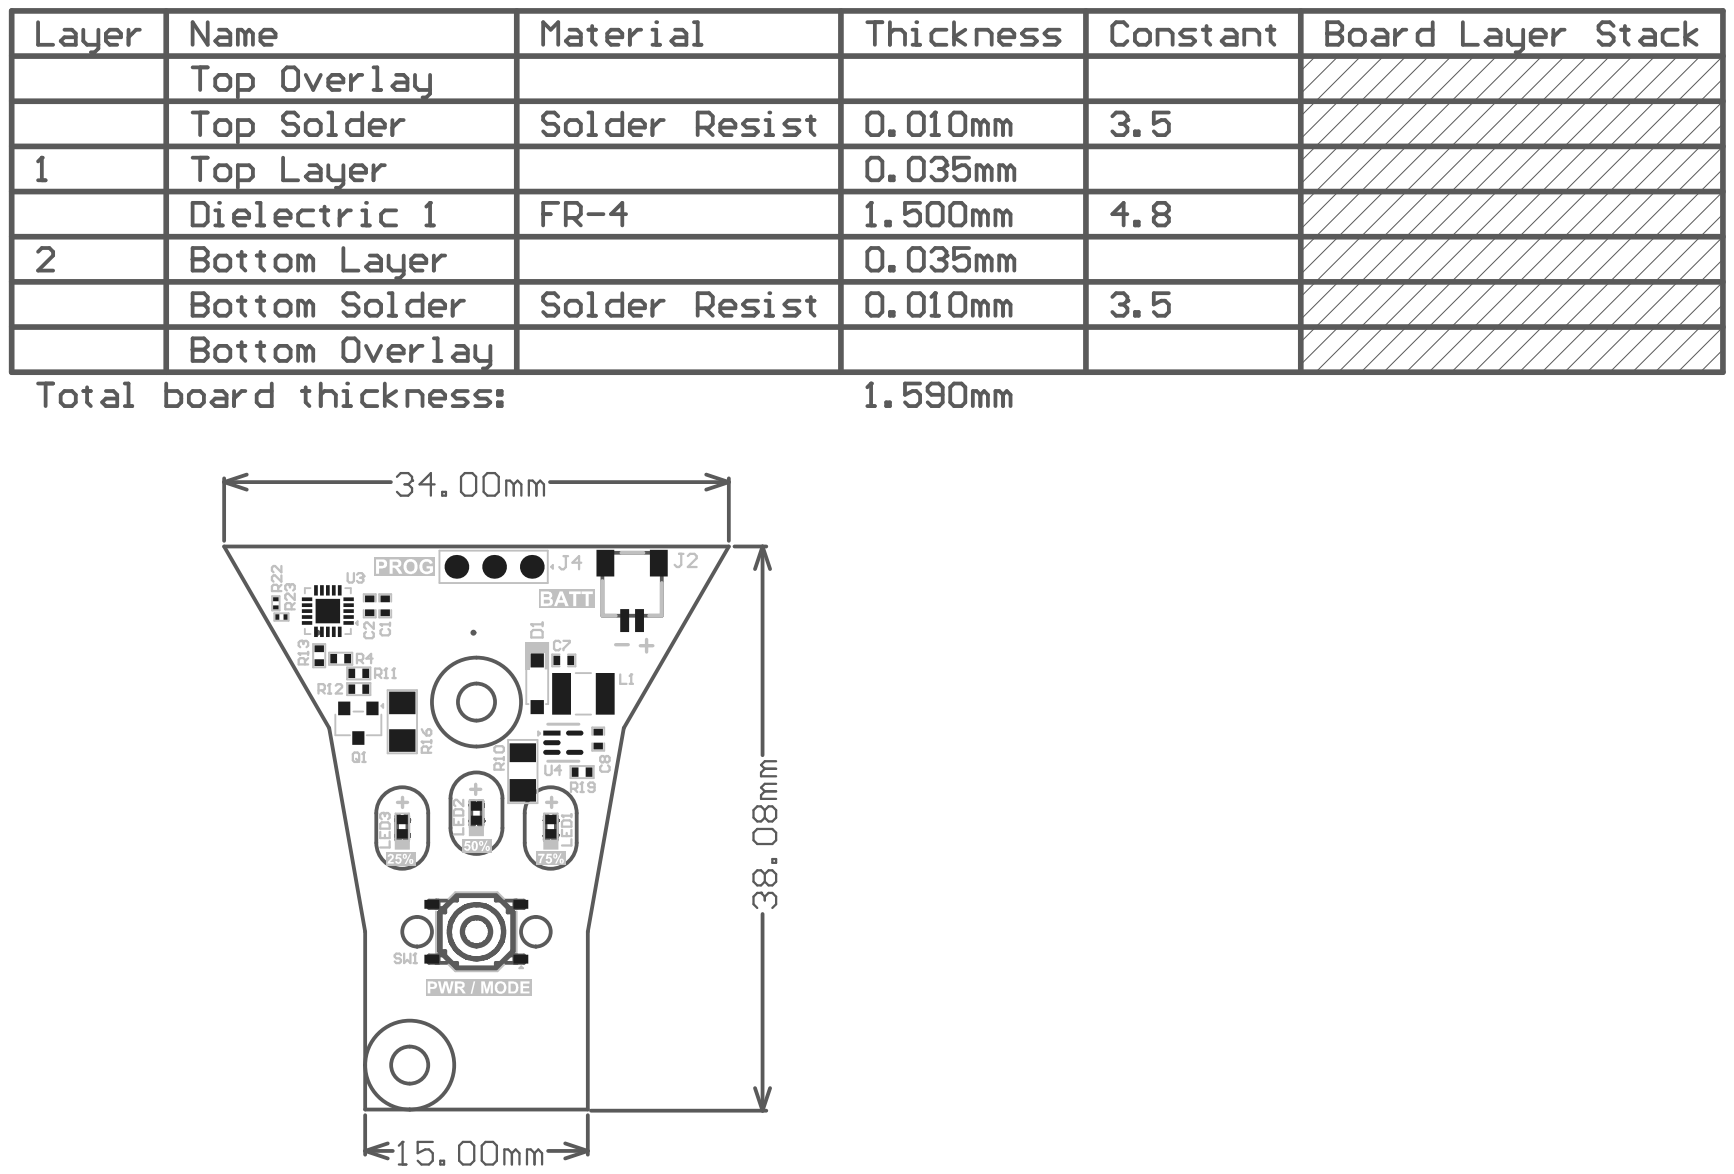
[picture p60: page 1]

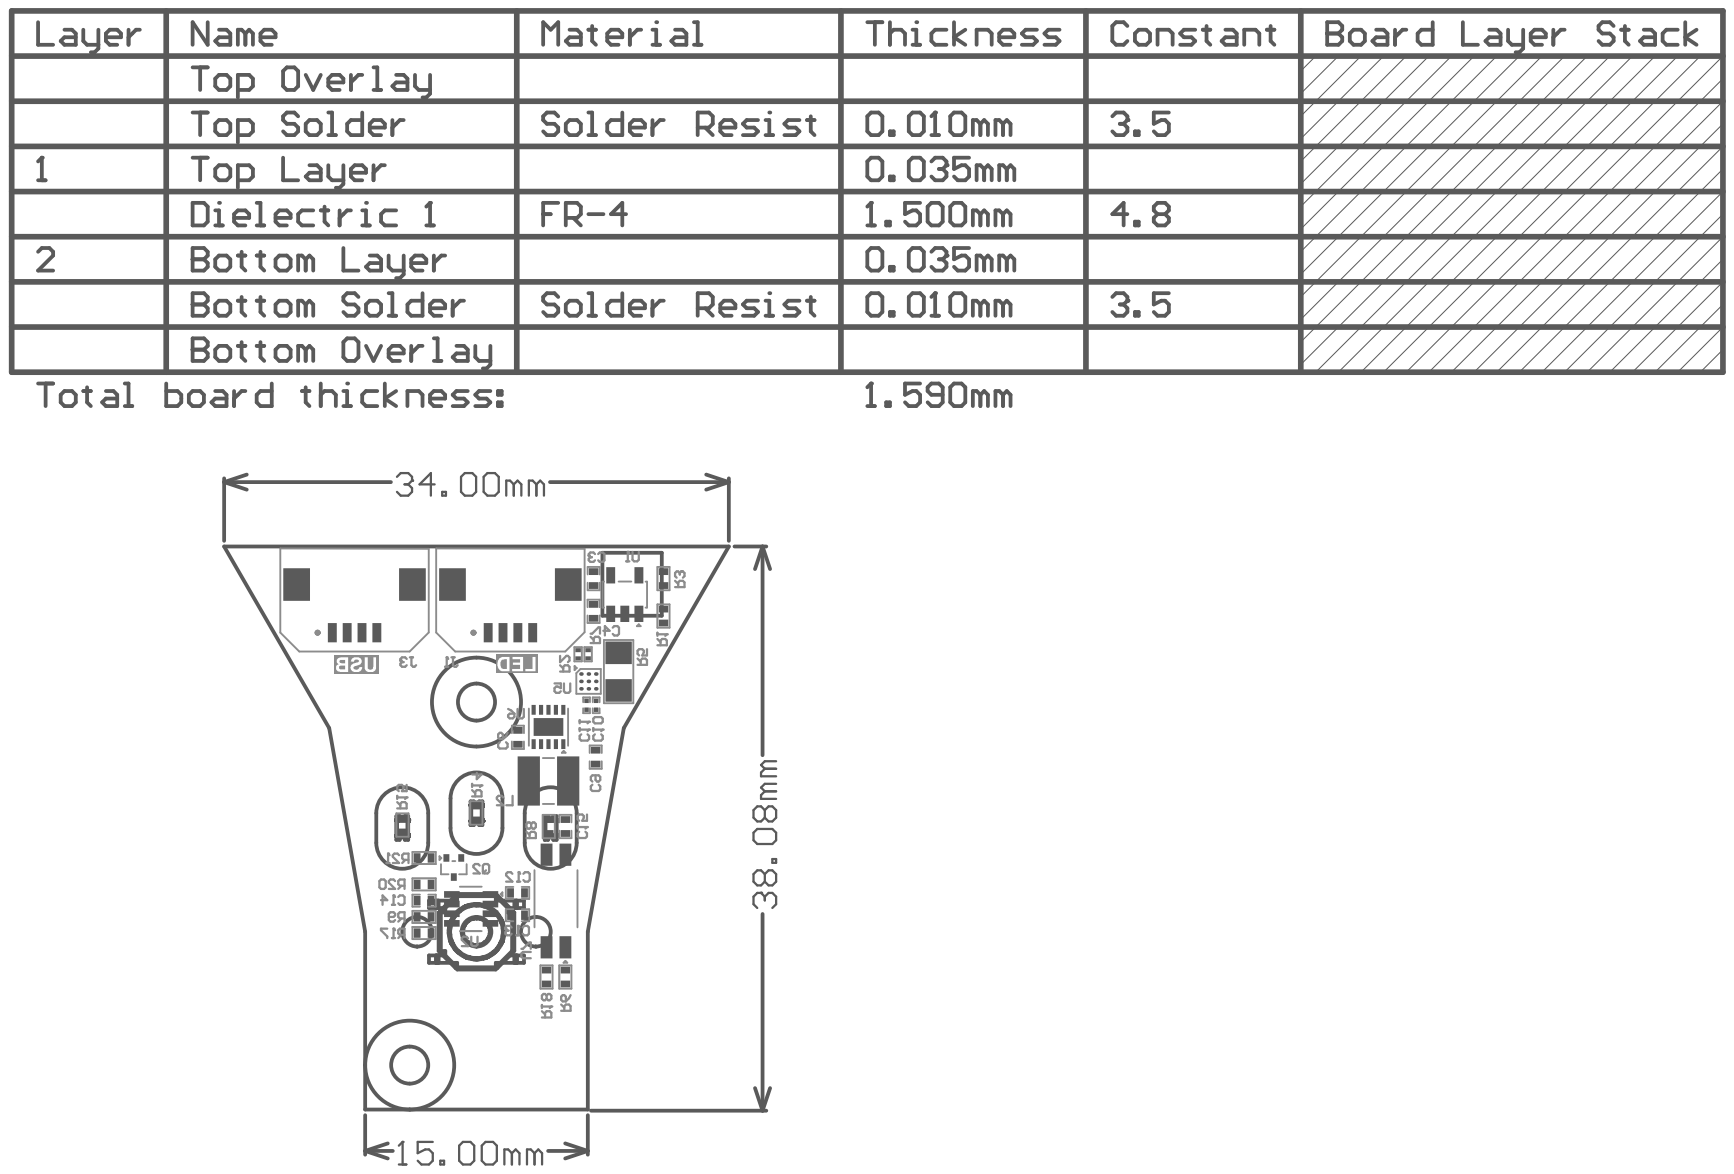
[picture p61: page 2]
