eSpark-Consulting-Group/brad-fairman-led-project/Design-Files/LED-Board_v1.0/Deliverables/Schematics/Assembly_Drawings_v1.0.pdf

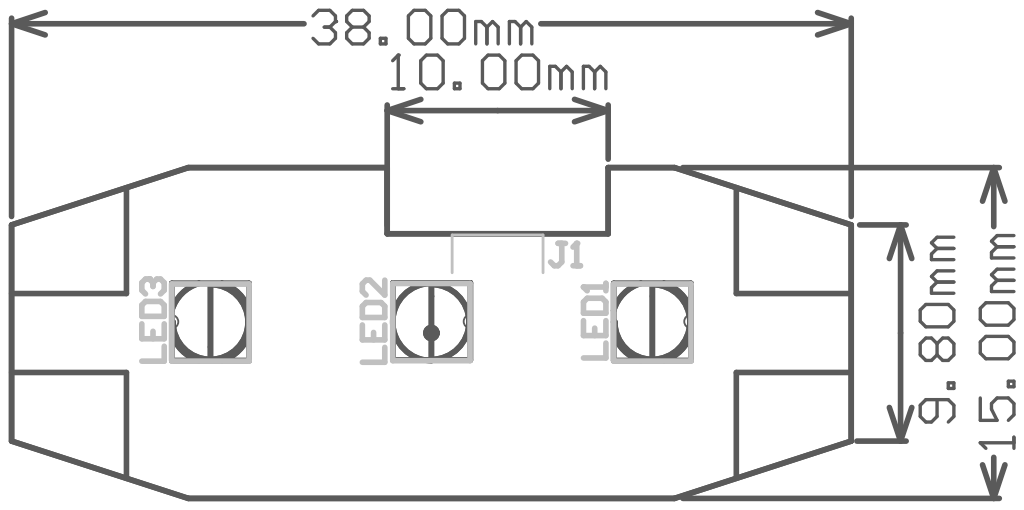
[picture p62: page 1]

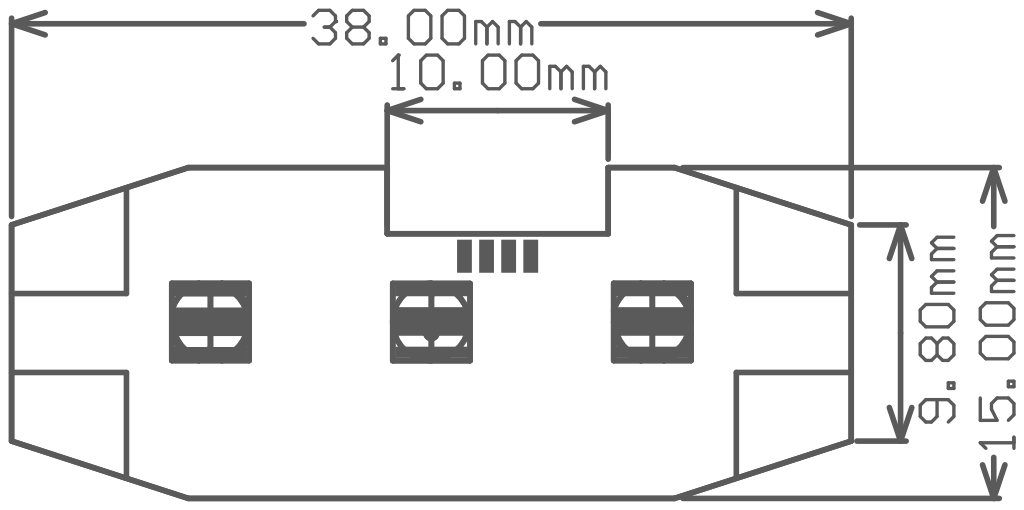
[picture p63: page 2]
