eSpark-Consulting-Group/brad-fairman-led-project/Design-Files/LED-Board_v1.0/Deliverables/Schematics/Schematics_LED-Board_v1.0.pdf

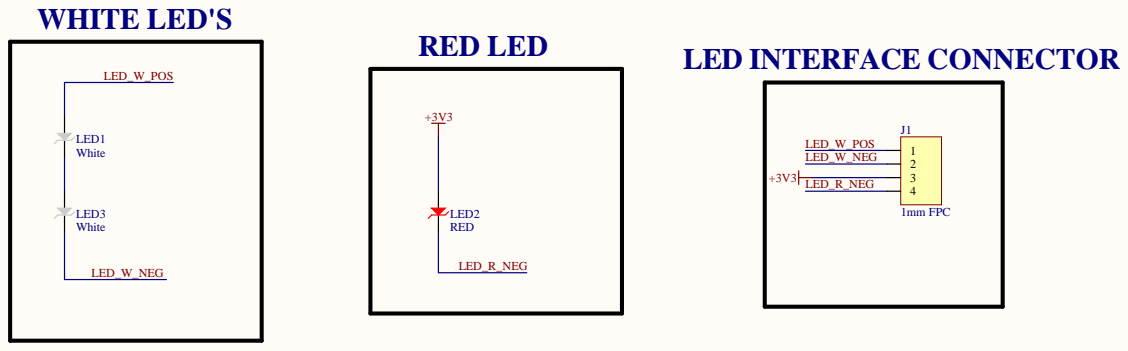
[picture p64: page 1]
