eSpark-Consulting-Group/brad-fairman-led-project/(list of files, drawings)

Other design files:
Design-Files/Button-Board_v1.0/Design File/Button-Board.PrjPcb
Design-Files/Button-Board_v1.0/Design File/Connector-Sheet.SchDoc
Design-Files/Button-Board_v1.0/Design File/Controller-Sheet.SchDoc
Design-Files/Button-Board_v1.0/Design File/LED-Driver-Sheet.SchDoc
Design-Files/Button-Board_v1.0/Design File/PCB_Button_Board.PcbDoc
Design-Files/Button-Board_v1.0/Design File/Power-Sheet.SchDoc
Design-Files/Button-Board_v1.0/Design File/Top-Sheet.SchDoc
Design-Files/Button-Board_v2.0/Design File/Button-Board_v2.0.PrjPcb
Design-Files/Button-Board_v2.0/Design File/Connector-Sheet.SchDoc
Design-Files/Button-Board_v2.0/Design File/Controller-Sheet.SchDoc
Design-Files/Button-Board_v2.0/Design File/LED-Driver-Sheet.SchDoc
Design-Files/Button-Board_v2.0/Design File/PCB_Button_Board_v2.0.PcbDoc
Design-Files/Button-Board_v2.0/Design File/Power-Sheet.SchDoc
Design-Files/Button-Board_v2.0/Design File/Top-Sheet.SchDoc
Design-Files/Flex-Cable-LED Board/Design Files/Flex-LED-Board_v1.0.PrjPcb
Design-Files/Flex-Cable-LED Board/Design Files/Flex-LED.SchDoc
Design-Files/Flex-Cable-LED Board/Design Files/PCB_Flex_LED_v1.0.PcbDoc
Design-Files/Flex-Cable-LED Board_v2.0/Design Files/Flex-LED-Board_v2.0.PrjPcb
Design-Files/Flex-Cable-LED Board_v2.0/Design Files/PCB_Flex_LED_v2.0.PcbDoc
Design-Files/Flex-Cable-USB/Design Files/Flex-USB_v1.0.PrjPcb
Design-Files/Flex-Cable-USB/Design Files/PCB_Flex_USB_v1.0.PcbDoc
Design-Files/Flex-Cable-USB_v2.0/Design Files/Flex-USB.SchDoc
Design-Files/Flex-Cable-USB_v2.0/Design Files/Flex-USB_v2.0.PrjPcb
Design-Files/Flex-Cable-USB_v2.0/Design Files/PCB_Flex_USB_v2.0.PcbDoc
Design-Files/LED-Board_v1.0/Design Files/LED-Board_v1.0.PrjPcb
Design-Files/LED-Board_v1.0/Design Files/LEDs_Sheet.SchDoc
Design-Files/LED-Board_v1.0/Design Files/PCB_LED_Board_v1.0.PcbDoc
Design-Files/LED-Board_v2.0/Design Files/LED-Board_v2.0.PrjPcb
Design-Files/LED-Board_v2.0/Design Files/LEDs_Sheet.SchDoc
Design-Files/LED-Board_v2.0/Design Files/PCB_LED_Board_v2.0.PcbDoc
Design-Files/USB-Board_v1.0/Design Files/USB_Board_v1.0.PrjPcb
Design-Files/USB-Board_v2.0/Design Files/PCB_USB_Board_v2.0.PcbDoc
Design-Files/USB-Board_v2.0/Design Files/USB-Sheet.SchDoc
Design-Files/USB-Board_v2.0/Design Files/USB_Board_v2.0.PrjPcb
