eSpark-Consulting-Group/brad-fairman-led-project/(commit log)

2024-08-23 status led blinking sequence implemented
2024-08-27 Project migrated to arduino
2024-09-04 Button issue fix
    on power on, mode changing when button released.
2024-09-16 update: LED brightness adjusted
    https://github.com/eSpark-Consultants/bradfairman-ledproject/issues/2#issuecomment-2353349588
2025-01-07 v2.5 Firmware; all functions implemented
    Hardware PWM utilized for White and Red leds control signals.
    TCA0 compare channel 2 for white led
    TCB0 for red led
2025-01-08 #9 Firmware changes
    Device will now work during charge mode.
2025-01-23 Brightness adjusted
    White LED medium intensity brightness adjusted
2025-01-24 #9 Brightness adjusted
    - White LED driver PWM adjusted to 50KHz
    - Fuel guage IC changed to SOC mode
2025-01-29 #10 Brightness adjusted
    white/red led brightness re-adjusted
2025-01-29 #10 battery level indication when low soc
    - when SOC <10%, board will show SOC lvl and than turn off
    - on mcu startup, indication leds will show SOC lvl
    - MODE_OFF_TIME changed to 5s (this should be changed back to 4s if Ton/Toff capacitors are changed to desired values)
2025-01-31 shutdown sequence; voltage threshold implemented
    - Low voltage threshold changed to 2.75v
    - Shutdown condition now also includes voltage threshold
2025-02-03 #11 Shutdown sequence
    - 1% SoC change alert enabled and SoC threshold changed to 20%
    - voltage low threshold changed to 2.9v
2025-02-13 Indication led fixes
    - <20% soc, status indicator will blink three times instead of two.
    - usb power source detection also checks battery voltage to determine if usb is still plugged in or not.
    - upon interrupt assert from ON/OFF controller, mcu would shutdown immediately. (no need to change capacitor vales)
2025-02-24 red led fix
    Fixed issue where on USB power source insertion, red LED would flash
